JoshuaEgwuatu/Fall-2023-Autonomous-Crawlspace-Inspection-Robot/Croomba V2/Documentation/ReadMe.md

Here is a brief description of each file:

## Signoffs
- Environmental Sensing file contains 
  - Compass Subsystem.md
  - Radon Sensor subsystem.md
- Movement file contains 
  - Revamp Chassis and Motor Signoff.md

## Final BOM
Final BOM encompassing all purchases

## Full schematic 
Full design system
