JoshuaEgwuatu/Fall-2023-Autonomous-Crawlspace-Inspection-Robot/Croomba V2/Documentation/Signoffs/README.md

This repository contains two files related to environmental sensing and movement subsystems.
All files presents the subsystem's constraints, buildable schematics, analysis, and bill of materials (BOM).
The files are organized as follows:

## Environmental Sensing
- **Compass Subsystem.md**
- **Radon Sensor Subsystem.md**

## Movement
- **Revamp Chassis and Motor Signoff.md**
