JoshuaEgwuatu/Fall-2023-Autonomous-Crawlspace-Inspection-Robot/Croomba V1/Documentation/Signoffs/Movement/Signoffs/Signoff Request - Chassis and Motors.pdf

The tank chassis [1] is responsible for being the main structural frame of the robot. This kit includes the main platform, th treads that are attached to the chassis, and the motors that will drive them.

## "What it's gonna do"

Size:
The chassis needs to be of an appropriate size in order to accommodate all of the components, but also fit into the 16 inch maximum height constraint.

Speed:
The motors need to have a torque that it is strong enough to overcome the robot's weight (discussed below), but also move at an appropriate speed of 0.2 m/s. This speed of a little less than a foot per second was selected by the team to allow enough time for sensor sampling but also move at a decent pace. Additionally, the robot must be able to move up a 30 degree incline. While crawlspaces differ in the makeup and slope of the ground, a maximum scenario is considered in which the quickest change in height and length takes place, or, the steepest and most rapid 30 degree slope.

Weight:
The Autonomous Crawl Space Inspection Robot will contain navigational and environmental sensing equipment as well as power components. It is important to have an accurate measurement of all of the materials' weights so that the robot can roomba around the crawlspace. Below is a table of the components that will be used in the design.

## " Specs and Constraints"

## Signoff Request - September 16th - Chassis and Motors

Friday, September 16, 2022 9:22 PM

Signoffs Page 1

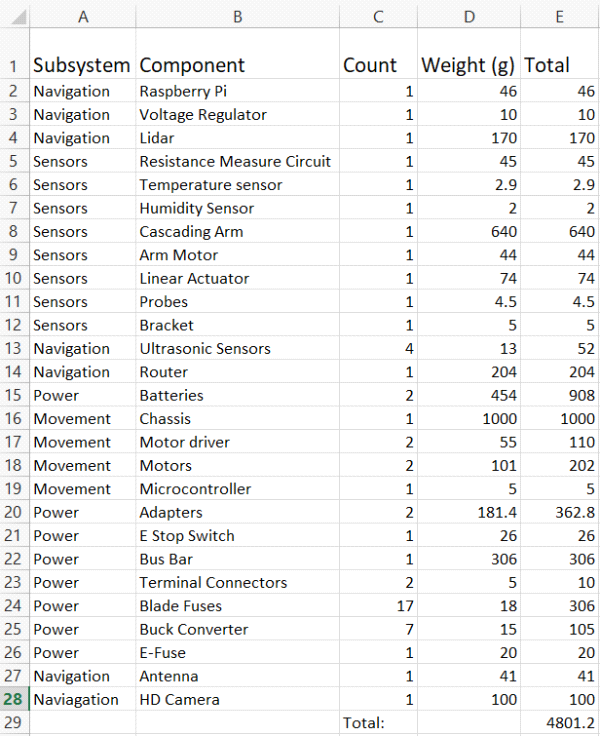
[picture p41: figure]

Table 1: Sum of Weights

Some items on the robot are not listed on the table, but are factored into the weights. An example of this instance is in the temperature sensor. Those 2.9 grams are both the arduino nano and the temperature sensor.

Additionally, this table does not indicate every piece of mass that will be added onto the robot (ex: wires). To account for (and any unforeseen circumstances), an additional calculation that assumes the robot weighs 7.2 kg, 50% more than the team expects, is made in the analysis section.

## "Analysis Compared to Constraints"

The Length Width and Height of the chassis kit in mm is 300/230/124. The surface area of the main platform is about 630 cm and the height of 124 mm is 4.88 inches, which provides the team with 11 inches worth of height for additional components such as the Lidar, Batteries, and cascading arm. More surface area can be added by attaching more platforms to the main platform included on the chassis if the need arises. Below is Figure 1, which featuresthe original kit when fully assembled. Note the amount of holes on the platforms that can be used for adding in more platforms if the need arises as well as the position

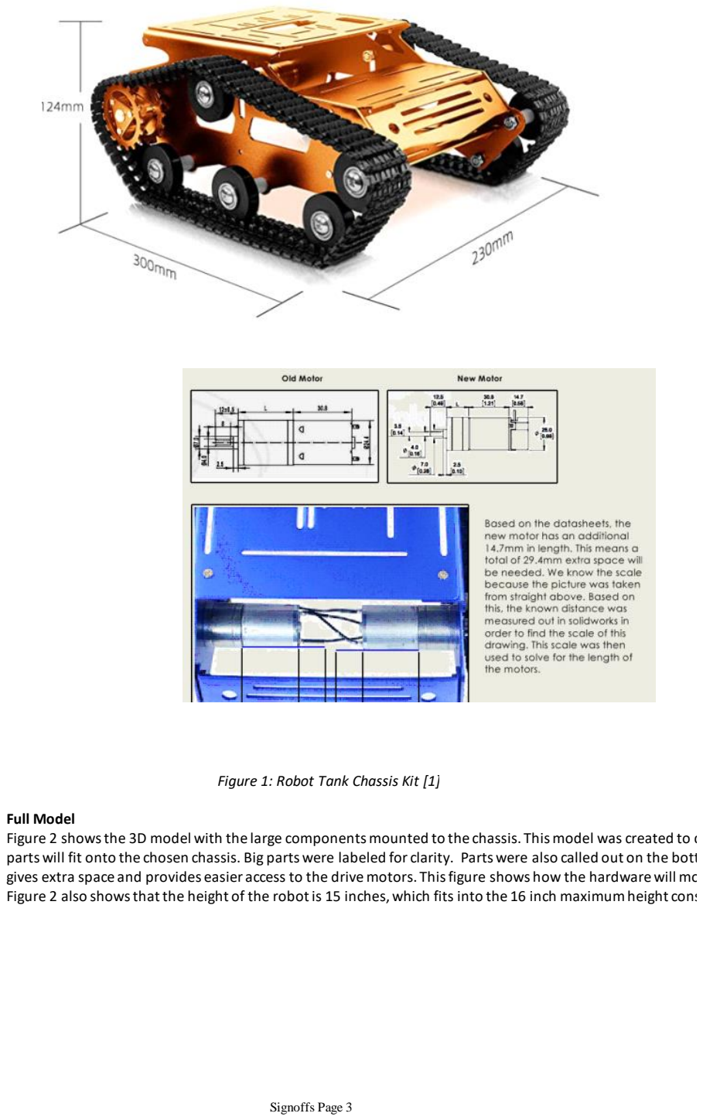
[picture p42: page 3]

Figure 1: Robot Tank Chassis Kit [1]

Full Model
Figure 2 shows the 3D model with the large components mounted to the chassis. This model was created to demonstrate that all parts will fit onto the chosen chassis. Big parts were labeled for clarity. Parts were also called out on the bottom of the
gives extra space and provides easier access to the drive motors. This figure shows how the hardware will mount onto the chas Figure 2 also shows that the height of the robot is 15 inches, which fits into the 16 inch maximum height constraint.

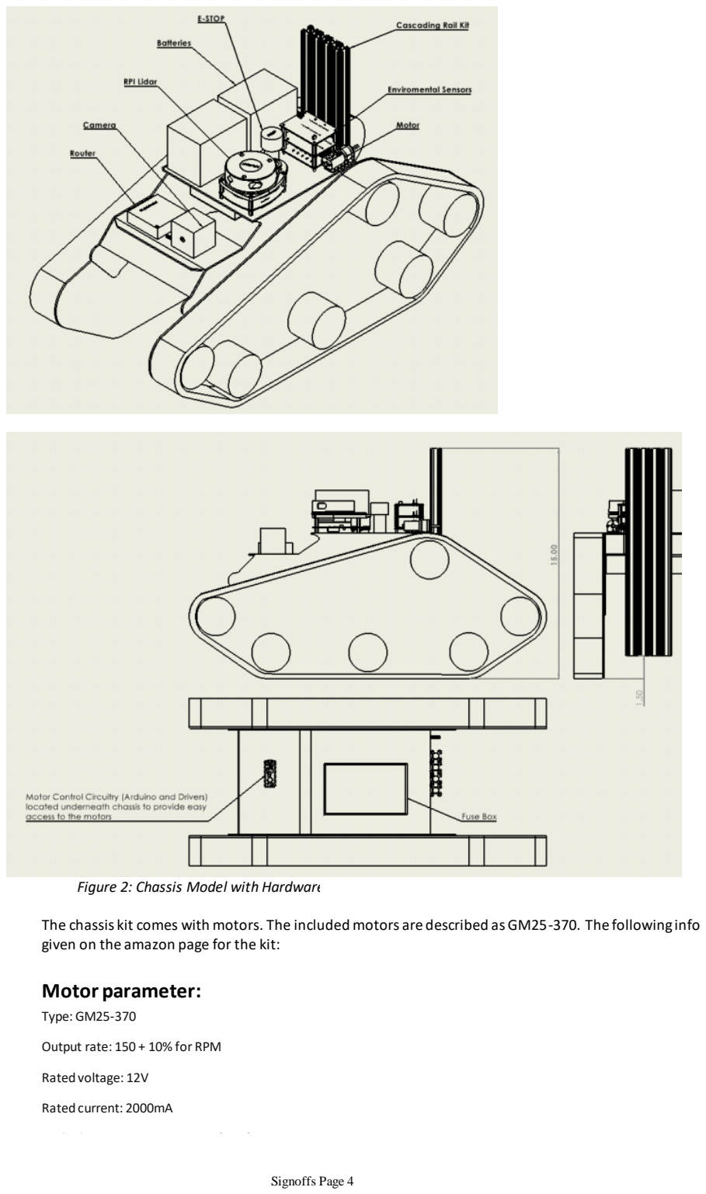
[picture p43: page 4]

Figure 2: Chassis Model with Hardware

The chassis kit comes with motors. The included motors are described as GM25-370. The following information is all that is given on the amazon page for the kit:

## Motor parameter:

Type: GM25-370

Output rate: 150 + 10% for RPM

Rated voltage: 12V

Rated current: 2000mA

Locked-rotor current: 4500 mA (Max)

KgNaN locked-rotor torque: 9.5kgNaN

Load speed: 100 + 10%rpm

[1]

The load torque: 3000 gNaN

A quick google of the part number brings up information on it from Pololu. Figure 3a shows the original motors physical dimensions. Based on the above information it is best assumed that the included motor has a reduction ratio of 34.

- The motor size must have a shaft diameter of 4mm with length of 12.5mm
- The new motor must be 25 mm in diameter
- The new motor must not exceed a length of 79.7mm in order to fit under the chassis

After comparing the specs provided in the product description on amazon with the different variations of the motor on pololu. The specs given on the motors included in the kit are inconsistent and undetailed, so to ensure a buildable and working produ new motors that can accommodate the design will be chosen. However, the new motor MUST have similar physical dimensions to the one included in the kit so that the included motors can be easily replaced. The physical size constraint for the motor follows:

To identify the strength and speed of the potential motor some calculations need to be made.

Inputs:
Wheel Radius: 0.01524 m (measured length of drive wheel in the kit)
Weight: 4.8 kg
Forward Velocity: 0.2 m/s
Max Incline: 30 degrees
Acceleration up incline: 0.1 m/s²

Angular velocity = forward velocity/ radius of wheel
=> (0.2m/s) / (0.01524m) = 13.1234 rad/s
=> (13.1234 rad/sec) * (1 rev/2pi rad) * (60 sec/min) = 125.3189 rpm

In the following torque equation, we divide by 2 to account for the 2 wheel drive.
Also, 125 rpm is about 56% of the max no load 220 rpm. We see from electronics stack exchange that torque, rpms, and efficiency all intersect at about 50% [2]. With the 56% of rpms calculated above, we'll assume a 50% efficiency in the calculations below. This accounts for some drops in efficiency possibly due to overheating or other stimuli.
Output Torque = (100/efficiency) * (weight * radius of wheel * (accel + g*sin(theta))) / 2
= (100/50) * 4.8kg * 0.01524m * (0.1 m/s² + 9.81*sin(30)) / 2 = 0.358391 Nm
Converting: 0.3583391Nm / (9.81m/s²
) * (100cm/m) = 3.732192 kgcm

3.732192 * 1.5 = 5.598288 (The aforementioned calculation that shows if the robot weighs 50% more than the team expects, then the motors can still handle it)

Current = Torque*angular velocity / voltage
3.732192 kgcm * 13.123 rad/sec / 12 V = 0.40028 A each

Based upon the calculations, a motor from pololu was chosen as the drive motors for the Autonomous Crawl Space Inspection Robot: Pololu item number 4845 [3]. This motor has nearly identical physical dimensions as the one included in the chassis ki with the only difference being the addition of the encoder (dimensions shown in Figure 3b), and its stall torque (15kgcm), no load rpm (220rpm), and corresponding range are adequate for the above calculations. A torque curve with that information is seen in Figure 4. The green dot represents the operating point for the robot, and it is well within the torque. The red dot s that even if the robot ends up weighing 50% more than the team expects (7.2 kg) then the motors will still be able to support the load. Comparing the motor lengths, diameter, and placement of the mounting holes shows that the mounting holes on the

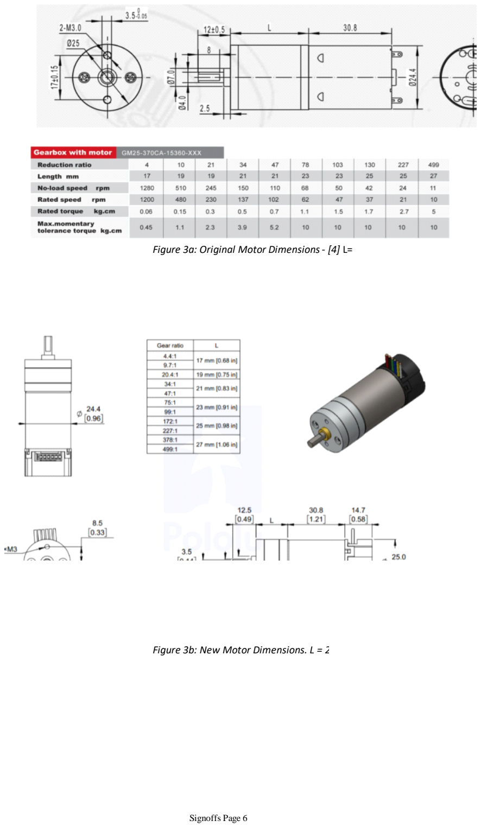
[picture p44: page 6]

Figure 3a: Original Motor Dimensions - [4] L= 21

Figure 3b: New Motor Dimensions. L = 21

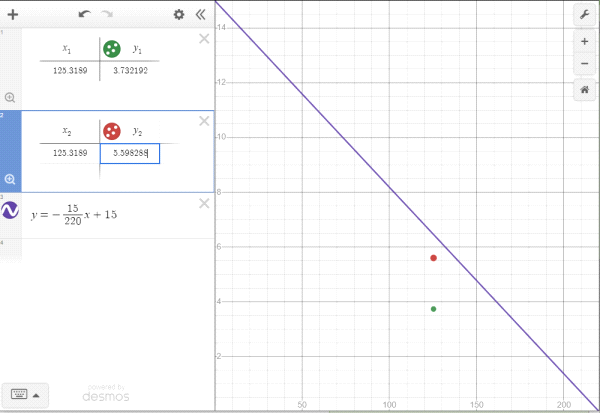
[picture p45: figure]

Figure 4: Torque Curve
X Axis: Speed (rpm)
Y Axis: Torque (kgcm)
An additional bonus of the selected motor is that it comes equipped a Hall Effect encoder that can be used to monitor the speed at which the motor is operating. However, the encoder adds an additional 14.7 mm onto the back of each motor. Referencing back to figure 1, it can be seen that the 29.4 mm of space necessary for the encoders is available. Therefore, the new motors will fit into the same space that the old motors used. Figure 5 gives a description with pictures on how the motor and encoder wires are to be connected.

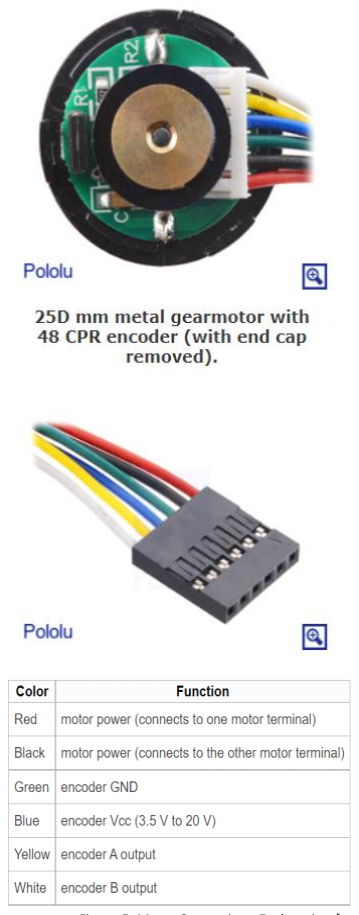
[picture p46: figure]

Figure 5: Motor Connections Explanation [3]

New Constraint: The 5A stall current of the motors places a constraint on to the motor driver that will be used to control th This information will be considered and analyzed in a future signoff.

These new motors will attach to the chassis in the same way that the original motors would have. Figure 6 shows the motor model, and Figure 7 shows how the motors will mount onto the chassis (Figure 7 is NOT a video. It is a photo taken from one, but the video can be found through source 1). The motors are attached to each side of the chassis by using two screws a piece The man seen in Figure 7 is installing a motor onto the chassis. Since the originally included motors and newly selected moto are physically identical, the new ones will mount in the same way.

Motor Mounting:

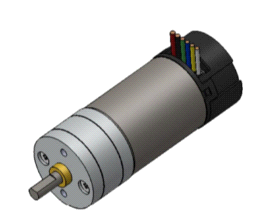
[picture p47: figure]

Figure 6: Motor Model - [3]

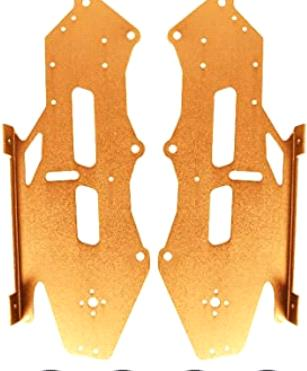
[picture p48: figure]
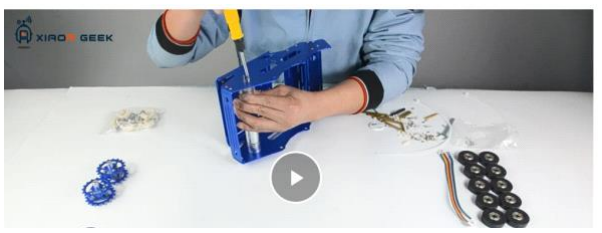
[picture p49: figure]

Figure 7: Motor Mounting - [1]

Each Pololu Motor costs $48.95 The Chassis Kit costs $74.99

[1] Chassis Kit (https://www.amazon.com/XiaoR-Geek-Aluminum-Raspberry-Absorbing/dp/B077Z4GYLB?hvadid=533431677067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)
[2] Typical Motor Efficiency (https://electronics.stackexchange.com/questions/237681/brushed-motor-torque-and-efficiency)
[3] Pololu Motor 4845 (https://www.pololu.com/product/4845)
[4] Original Motors (https://www.amazon.com/Gm25-370-Reduction-Motor-Gearbox-Robots/dp/B014R33IUY)
