JoshuaEgwuatu/Fall-2023-Autonomous-Crawlspace-Inspection-Robot/Croomba V1/Documentation/Signoffs/Power/Signoff Request - 4_18 - Battery signoff.pdf

Battery Adapter Subsystem Specifications

The battery adapter subsystem will provide a nominal voltage of 20 V and a maximum current of 10 amps for distribution via the 12 gauge wires.

Analysis
A variable resistor and digital multimeter will be used the verify that current and nominal voltages are being met. Readings of voltage will be taken across various resistance values to determine the nominal voltage of the battery/adapter system. The correct operation of the kill switch will be determined with the resistance and multimeter as well. Then using two 1 ohm resistors in series the fuse operation will be verified to ensure that system will break the circuit if currents reach unsafe levels. The figure below shows a buildable schematic of this analysis

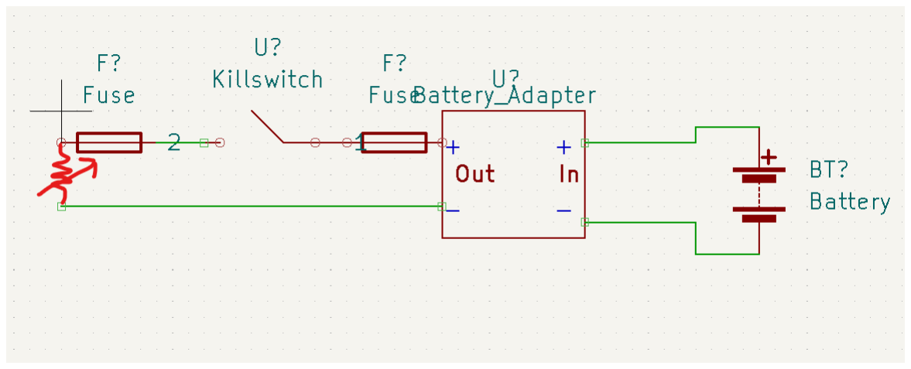
[picture p74: figure]

Battery Adapter Subsystem Expectations

The purpose of the battery adapter subsystem is to provide a safe connection from the battery terminals to the wires. There are four elements to this subsystem. The first element is the battery itself. The battery will provide current and voltage to the second element, the adapter. The adapter will be placed on the chassis attached with a shim. The adapter has a kill switch and fuses to protect the last element of the subsystem, the wires. The wires will be used to connect the rest of the power system together.

Battery - 20 V(max) 5.0 Ah https://www.amazon.com/DEWALT-DCB205-2-Lithium-Battery-2-Pack/dp/B00KQU1ENG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 (https://www.amazon.com/DEWALT-DCB205-2-Lithium-Battery-2-Pack/dp/B00KQU1ENG)

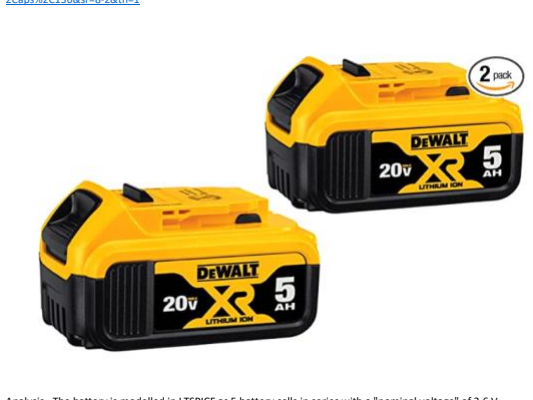
[picture p75: figure]

Analysis - The battery is modelled in LTSPICE as 5 battery cells in series with a "nominal voltage" of 3.6 V each. The tolerance was estimated to be 10% each. A monte-carlo simulation was executed with a simple resistive load to show some possible values :

# Signoff Request - 4/18

Monday, April 18, 2022 7:48 AM

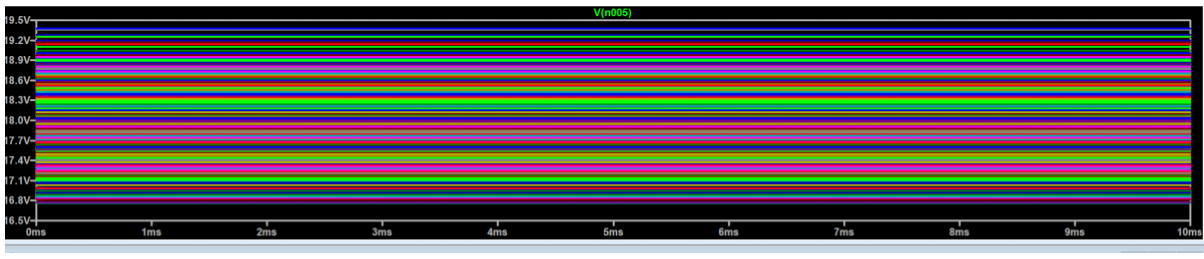
[picture p76: figure]

Journal - John Harris Page 1

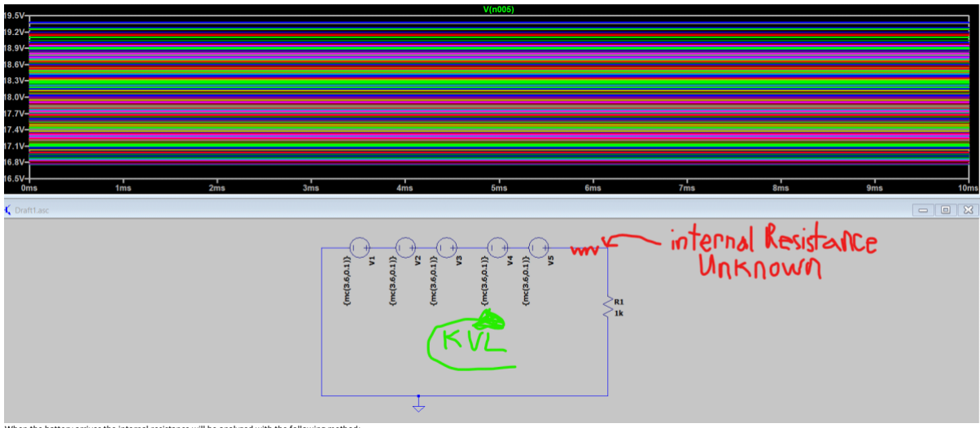
[picture p77: figure]

When the battery arrives the internal resistance will be analyzed with the following method:

The No Load Voltage will be determined at full charge by connecting a multimeter across the battery terminals. The Voltage will be recorded as the No-Load Voltage.

Once the No-Load Voltage is determined the external resistor's resistance will be measured and recorded with a multi meter. The resistor will be connected to the battery. The voltage will be measured across the resistor quickly to avoid damaging the battery.

Once the Voltage Across the external 1k resistor is known the Current will be determined by I = V/R

Once the current is known a KVL will be performed to determine the internal resistance : (no_load_voltage) = (current*internal_resistance) + measured_external_voltage

internal_resistance = no_load_voltage - measured_external_voltage / current

The internal resistance will be recorded and used to monitor battery health by repeating the experiment during trouble shooting if necessary.

Wire - (if not available in lab) https://www.amazon.com/dp/B08R34NG4P/ref=twister_B08XVR3YYD?th=1 (https://www.amazon.com/dp/B08R34NG4P/ref=twister_B08XVR3YYD?th=1)

Analysis: 12 gauge wire rated for a maximum of 9.3 A with about 1.5 ohm resistance every 1000 ft.

Inline Fuse - waterproof will use 2 in series ATC/ATO standard blade fuse 12 Gauge wire https://www.amazon.com/dp/B07RY8Y2QV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 wNjg4NzA1MTFLSFAzOEhJVEtZNSZlbmNyeXB0ZWRBZElkPUEwNDg5MzUzMU9aTTFGNVo4UVE0OSZ3aW RnZXROYW1lPXNwX2RldGFpbF90aGVtYXRpYyZhY3Rpb249Y2xpY2tSZWRpcmVjdCZkb05vdExvZ0NsaWNr PXRydWU= (https://www.amazon.com/dp/B07RY8Y2QV?s=automotive)

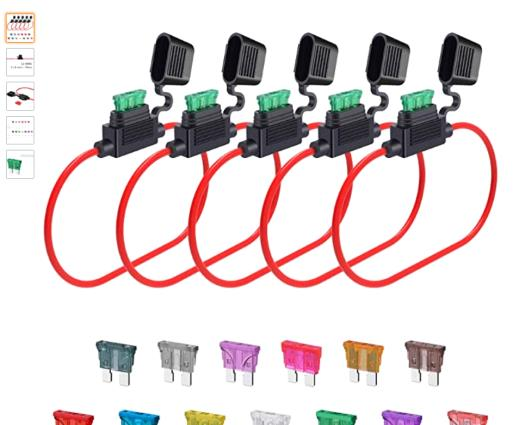
[picture p78: figure]

Analysis - The 12 gauge wire in line fuse of 10 A will break circuit if unsafe levels of current for wire are detected.

Battery Adapter - Integrated Kill Switch and Inline Fuse https://www.amazon.com/dp/B09HTB57MC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 NjI4MzgzM0gxMURROFlNQlZVMSZlbmNyeXB0ZWRBZElkPUEwNzQ2MzU5MklKNlczNUZERE1WNiZ3aWR nZXROYW1lPXNwX2RldGFpbF90aGVtYXRpYyZhY3Rpb249Y2xpY2tSZWRpcmVjdCZkb05vdExvZ0NsaWNrP XRydWU&th=1 (https://www.amazon.com/dp/B09HTB57MC?s=electronics)

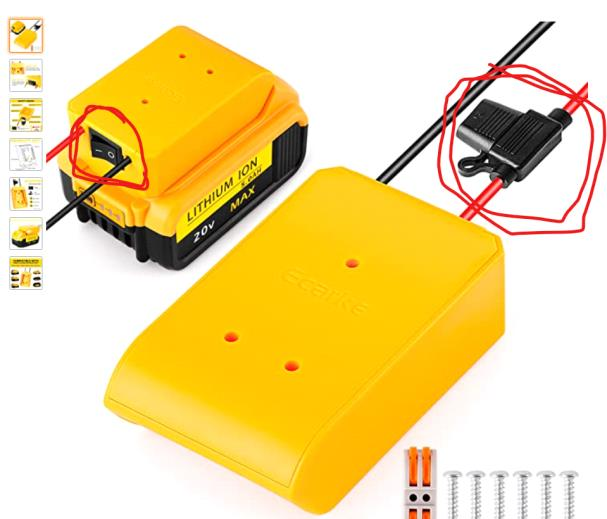
[picture p79: figure]

Analysis - 12 gauge wire with a 10 A fuse to break circuit if current gets too high

Attachment- The following figures illustrate the proposed method for adapter attachment to robot chassis. Care was taken to place batteries in a position that does not interfere with LIDAR or moisture probe.

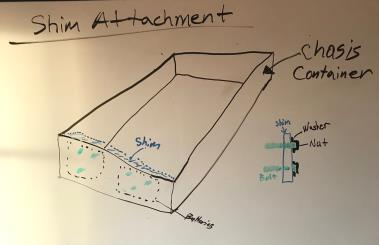
[picture p80: figure]
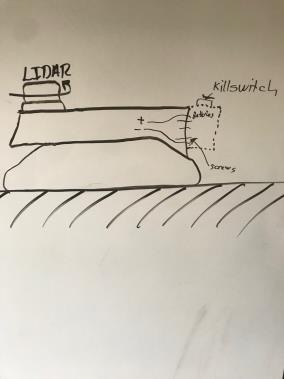
[picture p81: figure]

Battery Charger - (if not available in lab)

https://www.amazon.com/DEWALT-DCB118-FLEXVOLT-Fast-Charger/dp/B01HD4E0LK?th=1

Analysis - No analysis for this component it may not be necessary if a charger can be found
