JoshuaEgwuatu/Fall-2023-Autonomous-Crawlspace-Inspection-Robot/Croomba V1/Documentation/Signoffs/Power/SignoffRequest-914.pdf

## Signoff Request - 9/14

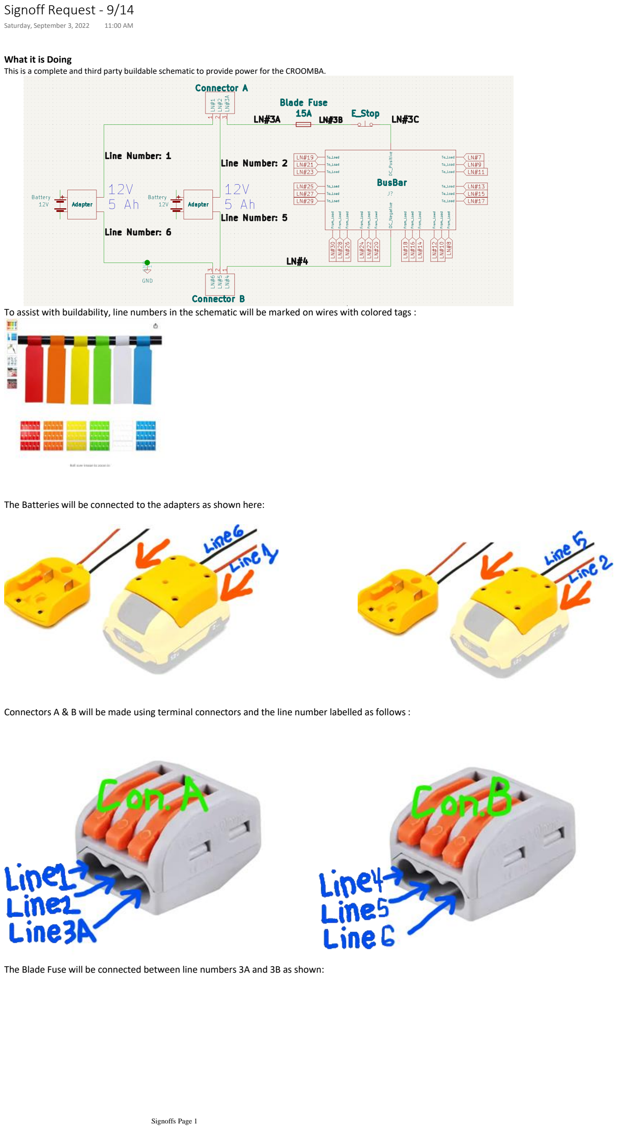
[picture p82: page 1]

What it is Doing
This is a complete and third party buildable schematic to provide power for the CROOMBA.

To assist with buildability, line numbers in the schematic will be marked on wires with colored tags :

The Batteries will be connected to the adapters as shown here:

Connectors A & B will be made using terminal connectors and the line number labelled as follows :

The Blade Fuse will be connected between line numbers 3A and 3B as shown:

Saturday, September 3, 2022 11:00 AM

Signoffs Page 1

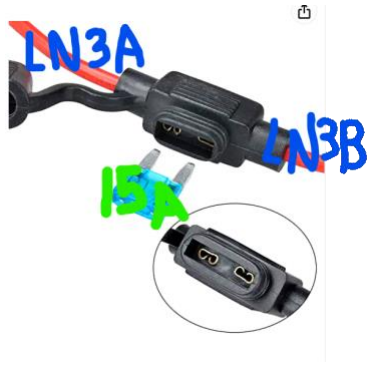
[picture p83: figure]

The on/off switch will be connected between line numbers 3B and 3C as shown here:

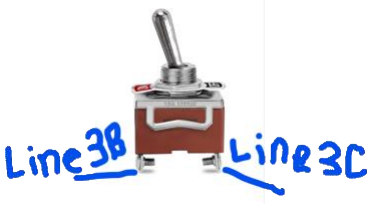
[picture p84: figure]

To complete the circuit, the busbar will be wired and labelled as follows:

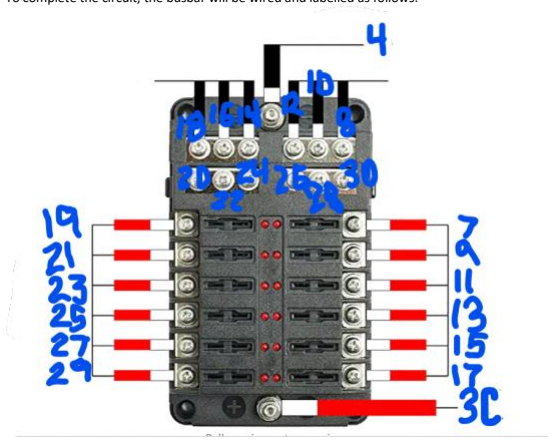
[picture p85: figure]

[1] Batteries (https://www.amazon.com/DEWALT-DCB126-2-Lithium-Batteries-2-Pack/dp/B08SKPTX4J)
[2] Adapters (https://www.amazon.com/gp/product/B09N42RJKW/ref=ask_ql_qh_dp_hza)
[3]E-Stop (https://www.amazon.com/MGI-SpeedWare-Latching-Toggle-Switch/dp/B08YYDPKR2?pid=J8qPn3Q&s=industrial)
[4]Bus Bar (https://www.amazon.com/dp/B093RF3VWC?s=automotive&sp_csd=d2lkZ2V0TmFtZT1zcF9kZXRhaWxfdGhlbWF0aWM)
[5]Wires (https://www.amazon.com/BNTECHGO-Silicone-Flexible-Strands-Stranded/dp/B01AAX65ZK)
[6]Terminal Connectors (https://www.amazon.com/dp/B09CKH8B5Q?s=industrial&sp_csd=d2lkZ2V0TmFtZT1zcF9kZXRhaWw)
[7]Blade Fuses (https://www.amazon.com/MUYI-Holder-Waterproof-Pigtail-Inline/dp/B07DHMHN4W)
[8]Micro USB Breakout (https://www.amazon.com/Poyiccot-Terminal-Connector-terminals-Pluggable/dp/B07PPXMTLL)
[9]USB C Breakout (https://www.amazon.com/dp/B08D93ZSM4?s=industrial&sp_csd=d2lkZ2V0TmFtZT1zcF9kZXRhaWw)

Constraints (FOR BUCK CONVERTER COMPONENT CONSTRAINTS SEE OTHER SIGNOFF REQUEST PLEASE)

Batteries- 12V Nominal output max of 5 amps in one hour before voltage begins to drop.
Wires- 14 gauge carry a maximum current of 15 Amps
Terminal Connectors- Rated for the gauge wire they are sized for.
Bus Bar- 100 Amp maximum current
E-Stop- 20 Amps at 12 Volts
Blade Fuses- 14 gauge 20 amp is listed as maximum current
Arduino Every- The USB port needs to kept open for serial communication between the Pi. It has an on board DC/DC converter input is 7-21V.

1. The power system must be portable. No plugs because they would get tangled.
2. Prevent fire hazard with overcurrent protections.
3. Distribute voltage and current to all components.
4. The Arduino and Raspberry Pi require a low ripple input voltage. This constraint is referred to as a ripple rejection and will require simulation in the Analysis to fully quantify.
4a. Arduino - The power for this system will enter through an onboard component called a Low Drop Out (LDO) Linear Voltage Regulator. The specific model used is LM1117IMPX-5.0. (https://www.digikey.com/en/products/detail/texas-instruments/lm1117impx-5-0/3697262) The Constraint for this comes from the maximum peak to peak voltage ripple this component can successfully filter out. The power then enters the ATMEGA328P and FT232RL. The voltage tolerance for these two components determine the allowable ripple.

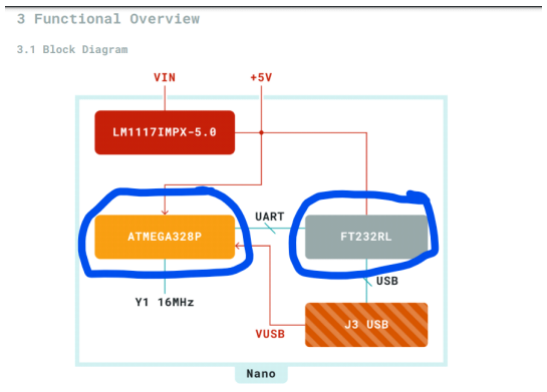
[picture p86: figure]
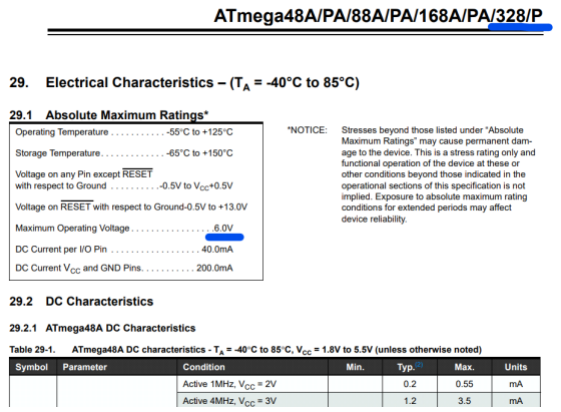
[picture p87: figure]
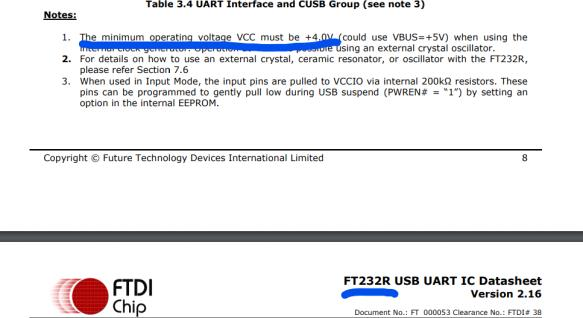
[picture p88: figure]

The maximum Ripple Allowed On the output of the LDO when both of these Components are considered is 1 V pk-pk

The LDO Regulator has a ripple rejection of 75dB:

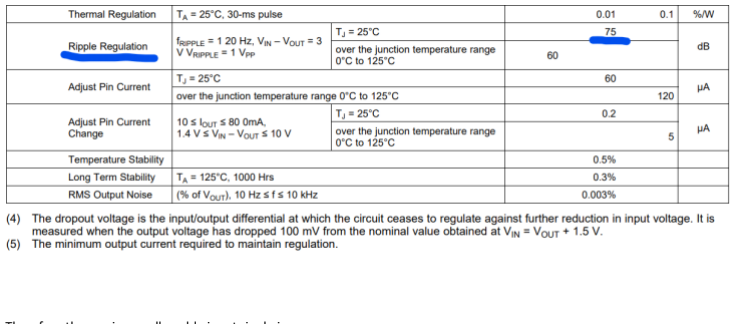
[picture p89: figure]

Therefore the maximum allowable input ripple is:

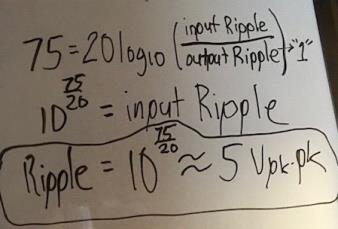
[picture p90: figure]

5V pk-pk

The Logic line for the H bridge drivers is powered through an on board L78M05 (https://www.digikey.com/en/products/detail/stmicroelectronics/L78M05CP/1165897) LDO which has a ripple rejection of 62 dB. The datasheet for the MOSFET (https://www.st.com/resource/en/datasheet/l298.pdf) of the driver indicates an absolute maximum in the logic line of 7V which indicates an output on the LDO of at most 2V pk-pk. With the ripple rejection the LDO is capable of this indicates a maximum input ripple of 2.5 V pk-pk

4b. Raspberry Pi - Here the power supply of the Raspberry Pi is used to determine the acceptable peak to peak voltage ripple.

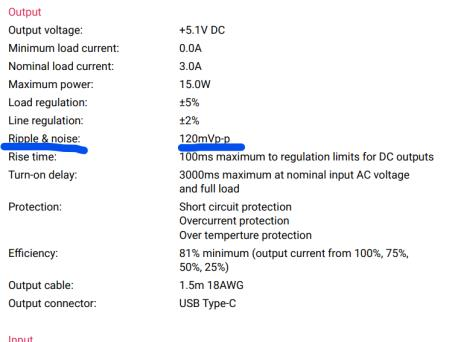
[picture p91: figure]

0.12V pk-pk

Analysis

Noise Simulation
In order to analyze the noise in the system we must simulate a ripple in a buck converter and come up with an implementable s olution for it. The Phenomenon of a ripple in the buck converter's voltage output is caused from a time varying magnetic flux density (when the inductor of the motor's field collapses from starting and stopp ing) coupling into some part of an adjacent system. The circuit component that is doing the coupling is an inductance. Whether it is a discrete inductor component or an inductance that is present in all real world wires is irrelevant. This is described in Maxwell's third equation:
The ripple will therefore be modelled by coupling an inductor that is being switched on and off into a buck converter simulation:

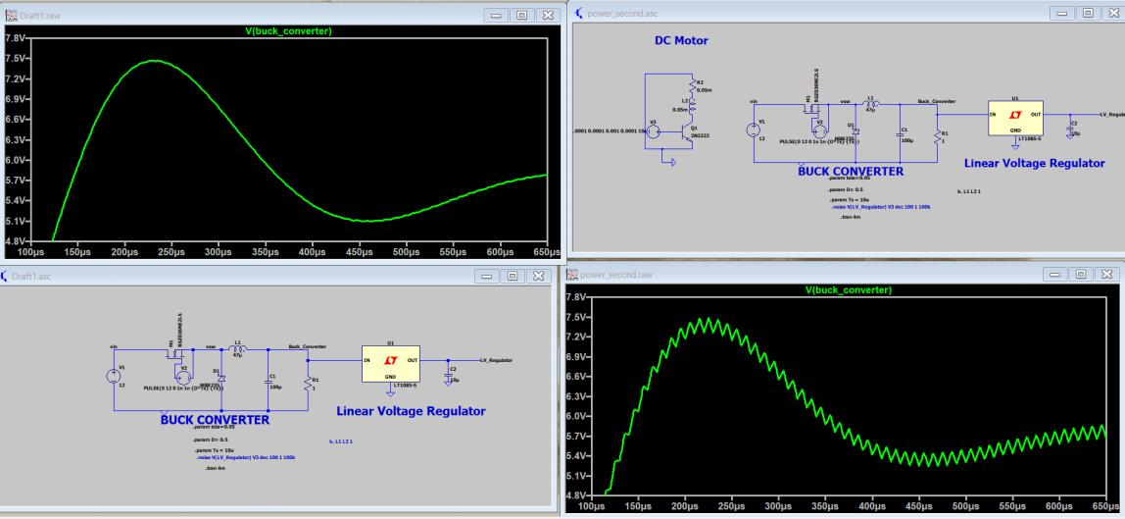
[picture p92: figure]

It can be seen from this figure that the ripple is seen on the output of the simulated buck converter. This figure shows the overall response in Comparison:

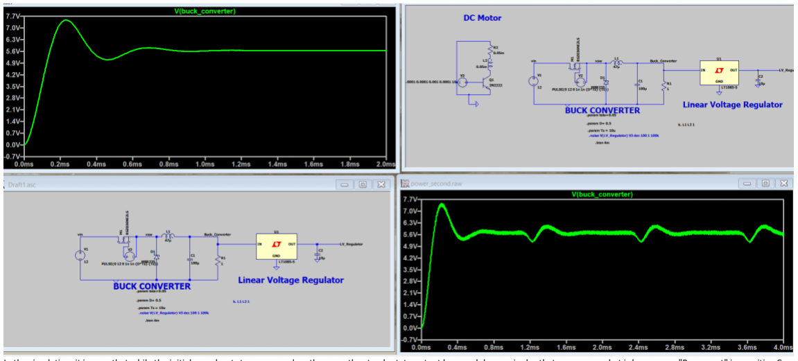
[picture p93: figure]

In the simulation, it is seen that while the initial overshoot stays more or less the same the steady state output has much l arger ripples that may cause what is known as a "Brown out" in sensitive Croomba systems if it is not controlled.

It will be demonstrated that a capacitor in parallel alleviates this problem and the response is then compared to maximum peak to peak voltage limits:

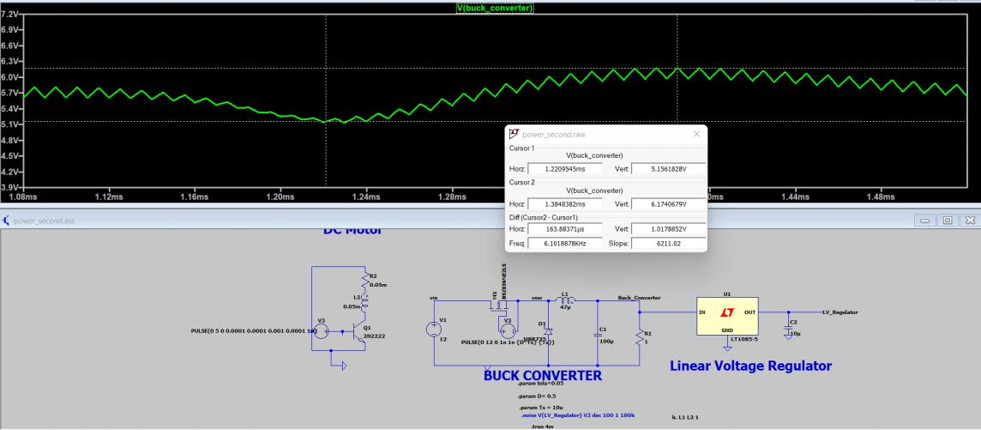
[picture p94: figure]

Here it can be seen that the voltage ripple is about 1.00V peak to peak. This puts the Design out of Specifications for the f ollowing components: Arduino: 5V pk-pk
Raspberry Pi: 0.12V pk-pk
LM298N: 1V pk-pk

A capacitor is used to decrease coupling by using the frequency of the buck converter(100kHz) and the inductance of the induc tor(47µH) with the following formula:

The required decoupling capacitor is calculated by rearranging the equation as

which is rounded to the nearest capacitance value of 0.1 .

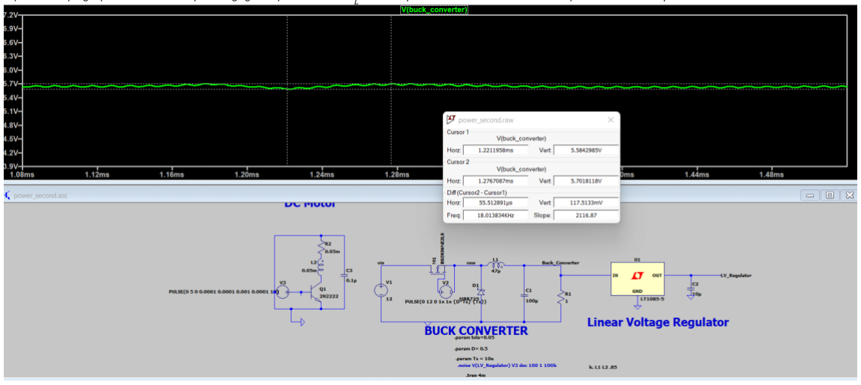
[picture p95: figure]

Here it can be seen that the voltage ripple is 0.117V peak to peak. This affects the Specifications for the following components: Arduino: 5V pk-pk
Raspberry Pi: 0.12V pk-pk
LM298N: 1V pk-pk

Here various Worst Case currents and voltages will be analyzed. In order to analyze the voltages and currents for the circuit, the loads across the bus bar must be estimated based and a noise analysis performed where possible. The analysis will proceed with a line by line estimation of the loads. Then conclude with the total load across the bus bar line numbers 3D & 4

Line 7A & 8A:

Buck Converter A >> eFuse >>Raspberry Pi

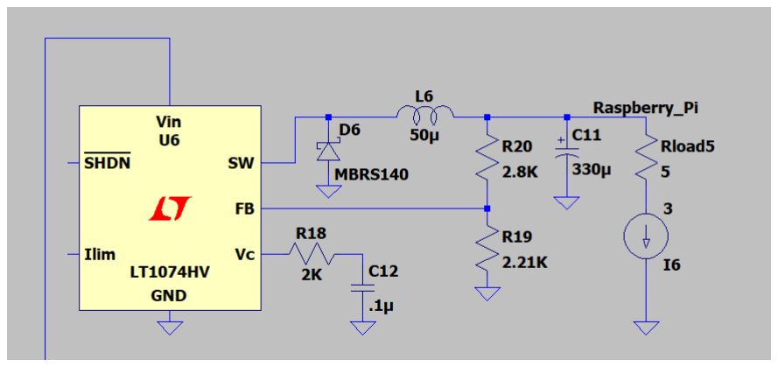
[picture p96: figure]
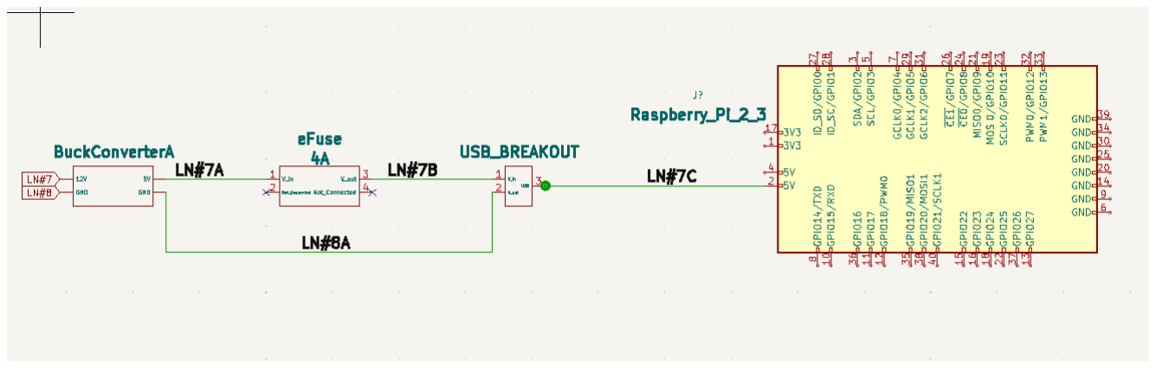
[picture p97: figure]

Worst Case Analysis
The base operating system has been installed on the Pi. It has been measured to consume 0.5 A at 5V during normal operation and 1A at 5V during start up. There will be four ultrasonic sensors that each consume 0.02A at 5V for a total of 0.08A at 5V provided through the Pi. There will be a LIDAR unit that requires 0.1A of current at 5V provided through the Pi. An HD camera will be used that consumes 0.15A at 5V provided through the Pi. A light that consumes 0.6A at 5V will be provided through the Pi. There will be an ESP32 connected that uses a maximum of 0.08A at 3.3V provided by the Pi. The input to the buck converter to provide this will have to be 5.1 * 2.01 / 12 = .854A at 12V. The buck converter efficiency at this current is about 84%, so to account for this: 0.854 * (1- 0.84 + 1) = 0.9906 A at 12V

The Worst Case current and voltage of this line is 0.996 at 12V

Line 9A & 10

This line will have the current and Voltage Requirements of the three environmental sensors for the CROOMBA. The change was made from previous signoffs to improve efficiency and reduce noise. The noise reduction happens from decreasing the total number of buck converters, which are a source of electrical noise. The buckconverters operate at an efficiency of about 75% at a load of about 0.5 Amps, but operate at an efficiency of about 83% at a load of 1.5 Amps.

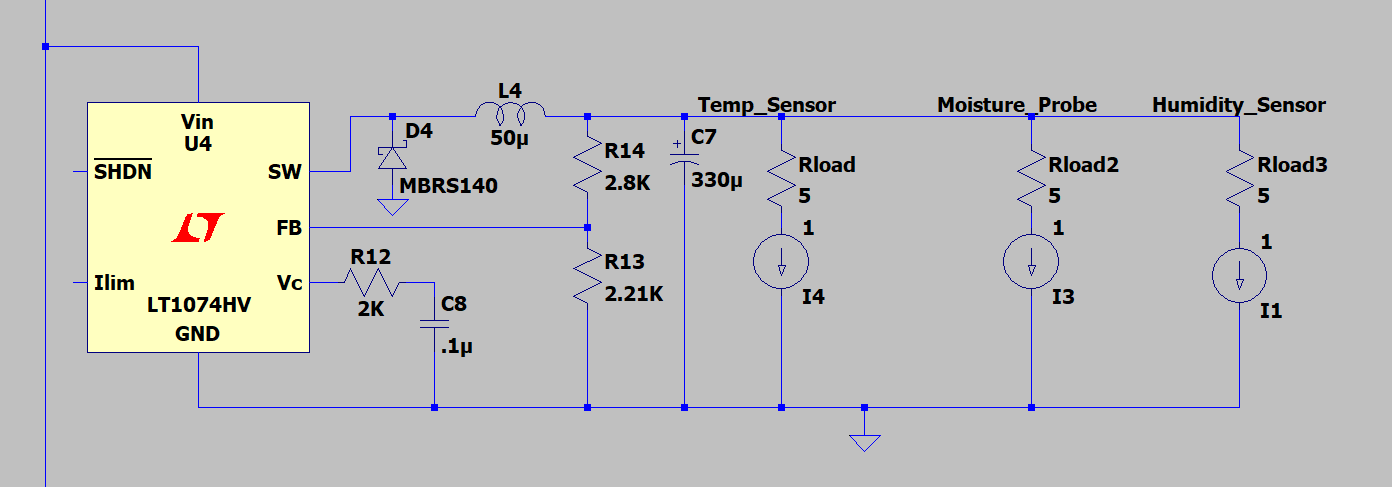
[picture p98: figure]
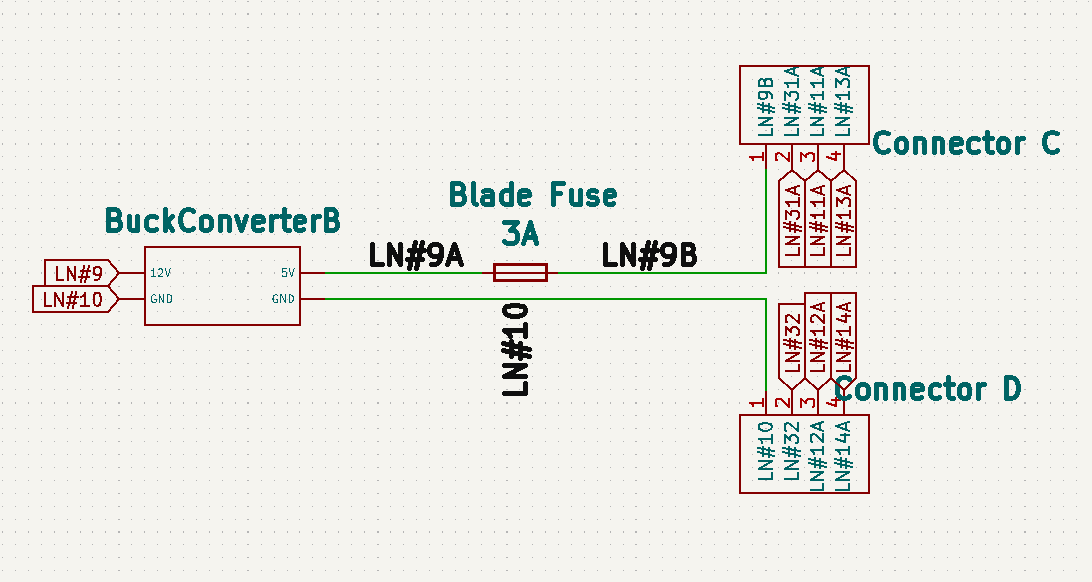
[picture p99: figure]

The input to the buck converter to provide this will have to be 5.1 * (0.785+0.785+0.3) / 12 = 0.7948A at 12V. The buck converter efficiency at this current is about 83%, so to account for this: 0.7948*(1-0.83 + 1) = 0.9299A at 12V

The Worst Case current and voltage of this line is 0.929A at 12V (Please see Lines 31A & 32, 11A & 12A, 13A & 14A for Calulations as a reminder this line is the sum of those three lines)

Line 31A & 32:
Buck Converter >> blade fuse >>Arduino Nano

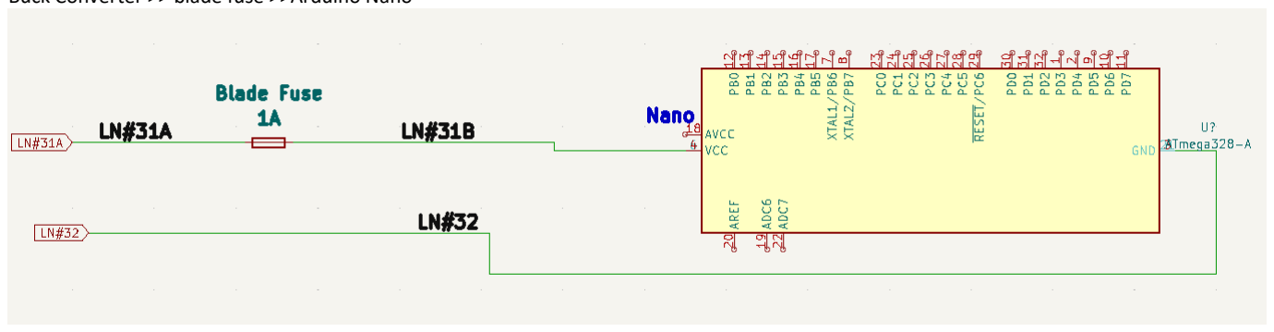
[picture p100: figure]
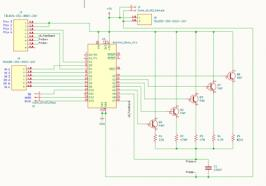
[picture p101: figure]

Worst Case Analysis
The Moisture content probe being operated by this Nano will require a maximum of 0.785 A at 5V. The calculations for this can be found in the environmental sensing signoff requests. "As shown in the schematic, this circuit is using 18 I/O pins, 14 of which will be set for output. Furthermore, only one of the auto-ranging ohmmeter pins will be outputting at a time. Along with the MCU, the auto-ranger is able to pull 0.206962 Amps through whichever transistor is active (based on LTSpice simulation created for that signoff). Adding the max board current, max pin current for each I/O pin, and the separate auto-ranger current, the maximum current pulled by this module at any point is 0.785 Amps. This measurement is a maximum however, all I/O pins will not be on at the same time or pulling max current under normal operation."

The Worst Case current and voltage of this line is 0.785A at 5V

Line 11A & 12A:
Buck Converter >> blade fuse >>Arduino Nano

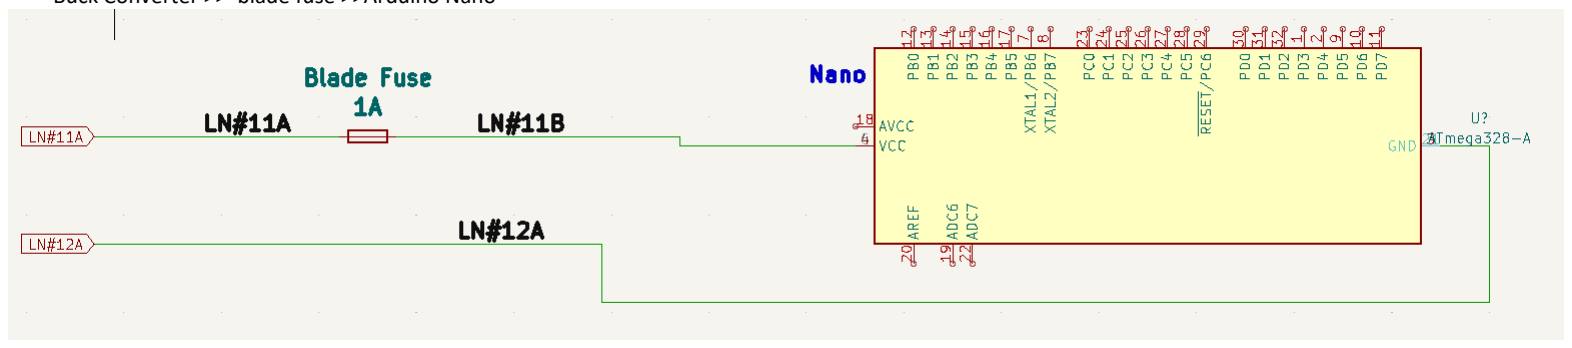
[picture p102: figure]
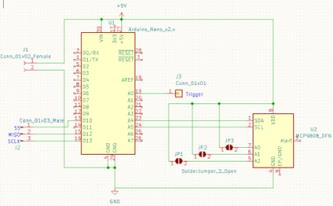
[picture p103: figure]

Worst Case Analysis
The Temperature probe being operated by this Nano will require a maximum of 0.785 A at 5V. The calculations for this can be found in the environmental sensing signoff requests. "This subsystem has 6 I/O pins being used as outputs from the Nano. The temperature sensor chip that is on its own power will pull 200 μA for its operating current based on its datasheet. (https://ww1.microchip.com/downloads/aemDocuments/documents/OTH/ProductDocuments/DataSheets/MCP9808-0.5C-Maximum-Accuracy-Digital-Temperature-Sensor-Data-Sheet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) Adding these values along with the inherent 19 mA board current shows 259.2 mA as the max current."

The Worst Case current and voltage of this line is 0.785A at 5V

Line 13A & 14A:
Buck Converter >> blade fuse >>Arduino Nano

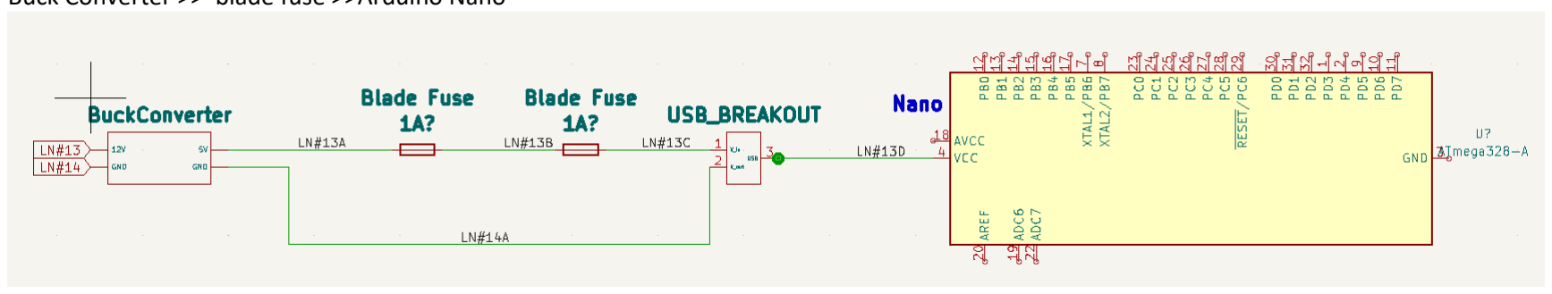
[picture p104: figure]

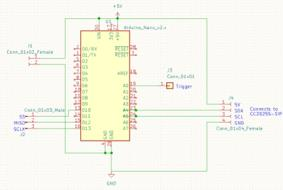
[picture p105: figure]

Worst Case Analysis

The Humidity Sensor being operated by this Nano will require a maximum of 0.3 A at 5V. The calculations for this can be found in the environmental sensing signoff requests. "This system also has 6 I/O pins in use and a separate sensor chip which, based on the datasheet, will pull a supply current of 750 mA." Adding all current values gives a total of 259.75 mA.

The current and voltage of this line is 0.3A at 5V

Line 15 & 16:
Buck Converter >> blade fuse >>Router

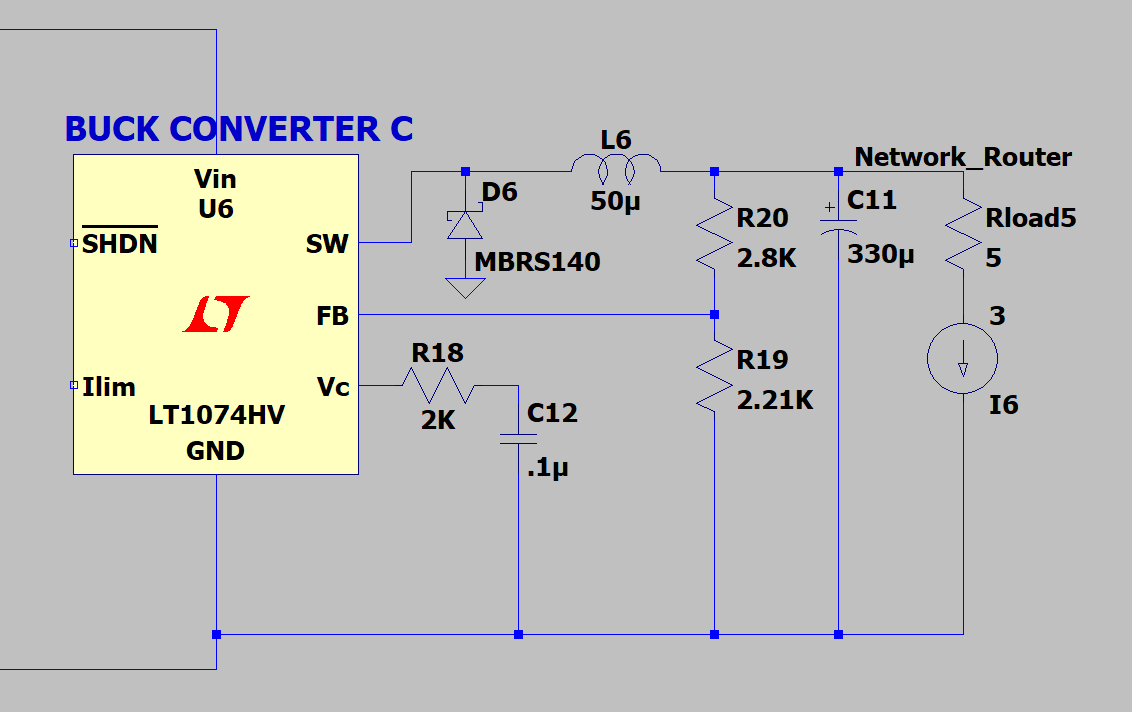
[picture p106: figure]

Worst Case Analysis
The power calculations found in the Navigation Signoff request indicate the router will use 1A at 5V."The nano router requires a constant voltage of 5 Volts and a constant current of 1 Amp for operation [3]. Over one hour, the N300 router would use approximately 1 Amp Hours (AH) and 5 Watt Hours (WH)." The input to the buck converter to provide this will have to be 5.1 * 1 / 12 = 0.425A at 12V. The buck converter efficiency at this current is about 83%, so to account for this: 0.425* (1- 0.83 + 1)=0.4973A at 12V

The current and voltage of this line is 0.4973A at 12V

Line 19 & 20:
Blade Fuse>>Blade Fuse>>L298N

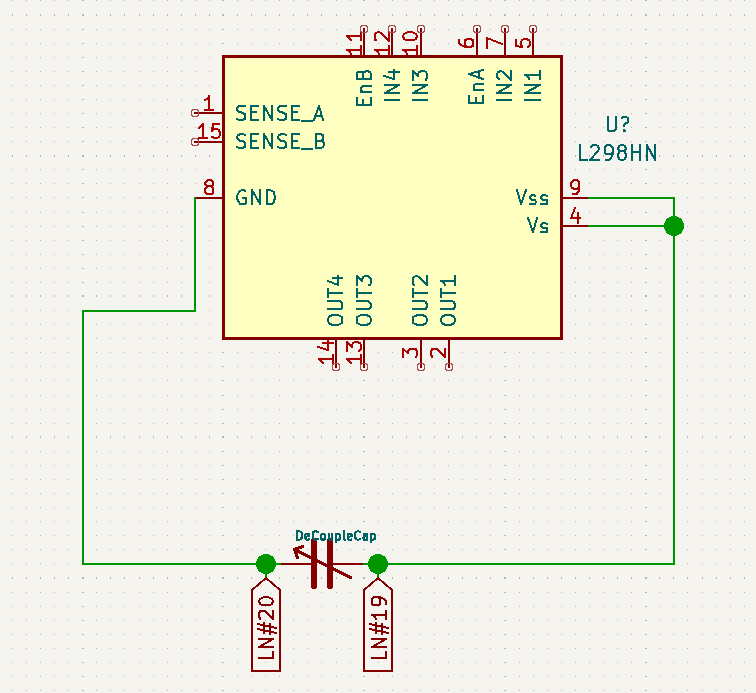
[picture p107: figure]

Worst Case Analysis
This line will provide the power used by the two DC motors that will move the CROOMBA and the logic line for the L298N. According to the datasheet for the H-bridge driver the logic supply voltage is typically 5V and the current is at a maximum (worst case) of 0.036A . The locked rotor current for the motors selected have been told to me to be : 1.8 amps * 2 motors = 3.6 A

The worst case current and voltage of this line is 3.64A at 12V

Line 23 & 24:
Blade Fuse>>Blade Fuse>>L298N

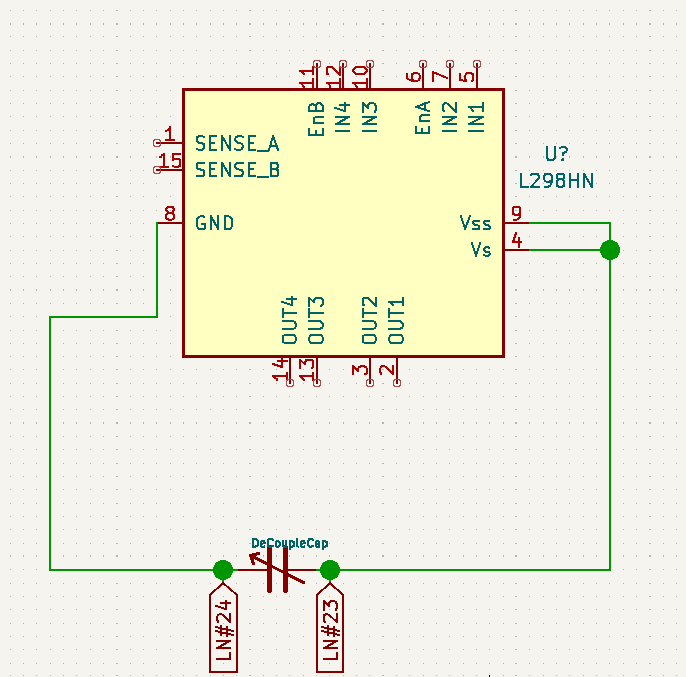
[picture p108: figure]

Worst Case Analysis
This Line will provide power to a rotational motor, a much smaller linear actuator, and the logic level of the MOSFET. According to the datasheet for the H-bridge driver the logic supply voltage is typically 5V and the current is at a maximum (worst case) of 0.036A . The motors will be powered off a separate source than the Arduinos will because they need higher voltage and will steal more current. The linear actuator has a stall current of 650 mA based on the product page while the rotational motors stall current is 1.6 Amps based on its website. The motor driver running these two can pull up to 36 mA internally when it is operating the motors based on the datasheet. This means that the total current the motors in this system will pull comes out to 2.246 Amps.

The worst case current and voltage of this line is 2.27A at 12V

Line 25B & 26:
blade fuse >> blade fuse >>Buck Converter >>Arduino Every

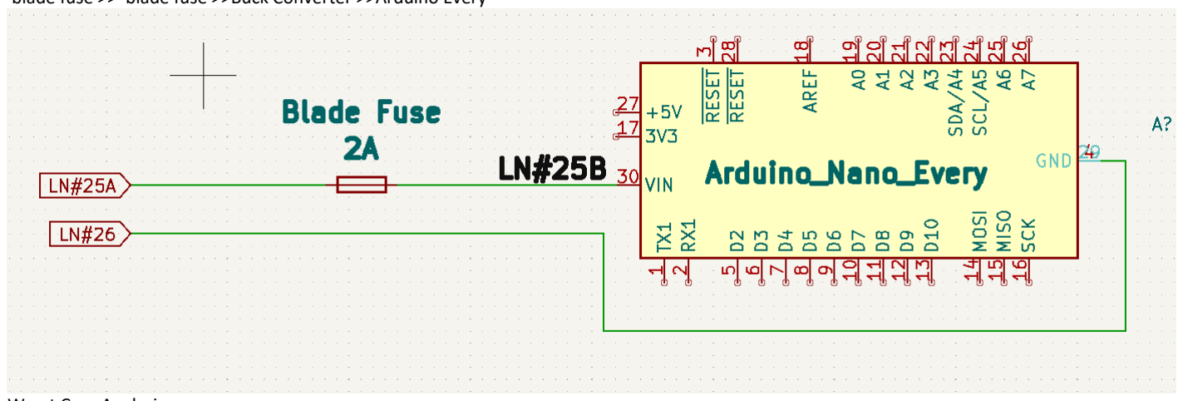
[picture p109: figure]

Worst Case Analysis
This line will provide the power for the Arduino Every. The arduino every has an on board MPM3610 DC to DC converter that, according to the manufacturer operates at 86% efficiency at 12V input. The maximum current the DC/DC converter can handle according to the datasheet is 1.2A at 12V. At 86% efficiency the board will require 1.2*(1-0.86+1) = 1.368 A at 12 .

The current and voltage of this line is 1.368A at 12V

Line 27 & 28:
Not Connected

Line 29 & 30:
Not Connected

Line 3D & 4:
The total power required will be 1.368+2.27+3.64+0.929+0.996=9.203A at 12V
The two 5 Ah batteries in parallel should be able to provide 9.203 A for 10/9.203 = 1.0866 Hours
