JoshuaEgwuatu/Fall-2023-Autonomous-Crawlspace-Inspection-Robot/Croomba V1/Documentation/Signoffs/Movement/Signoffs/Signoff Request - Motor Driver and Microcontroller.pdf

## "What it's gonna do"

The Mechanical Movement System requires Motor Drivers that will be used to control the motors and act as an interface between them and the control circuitry. This is necessary because motors operate at a high current and voltage, and the control circuit works on low current signals. [1] Speaking of control circuitry, this signoff will also be for the microcontroller that will be responsible for creating a closed feedback loop. This microcontroller will interpret movement instructions delivered by the Raspberry Pi from the Nav System, and also monitor the speed of the robot by making use of the Hall Effect Encoders that come on the selected

## "Specs and Constraints"

Microcontroller
- Communicate with the Raspberry Pi
- PWM Capability to control motor speed
- Enough GPIO pins (to be calculated below)

Motor Driver
- Accept PWM input to control motor speed
- Bidirectional movement

Specifications:

Microcontroller
- Vin must accept 12V. This constraint comes from the bus in the Power System.
- At least 2 PWM pins and channels must exist to send signals to the driver
- SPI, I2C, or Serial Capabilities must exist to communicate with the Pi.
- Read digital input of a maximum of 48 counts per revolution from the motor controller

Motor Driver
The 5A stall current from the motors means that the driver must be able to support a maximum of 5A

•

- Operate at 12V. This constraint also comes from the motors.

Constraints

## "Analysis"

The first component to discuss is the selected motor driver from Cytron Technologies, the MD20A [2].
"The MD20A enables bidirectional control of one high-power brushed DC motor from 6V to 30V. With discrete NMOS H-Bridge design, this motor driver is able to support 20Amp continuously without any heatsink" [2].
"This motor driver can be controlled with PWM and DIR inputs. With input logic voltage range from 1.8V to 12V, it’s compatible with wide variety of host controller (e.g. Arduino, Raspberry

## Signoff Request - September 16th - Motor Driver and Microcontroller

Friday, September 16, 2022 9:23 PM

Signoffs Page 1

Pi, PLC)" [2].

Since the MD20A can only support one motor, two motor drivers will be necessary; however, this helps to increase the modularity of the design by having a separate driver for each motor. The driver can be seen in Figure 1.

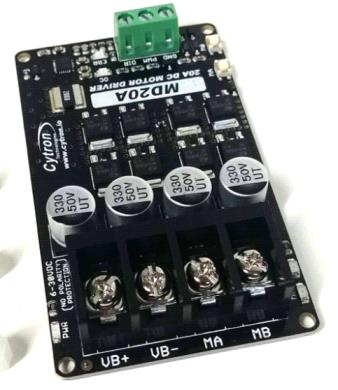
[picture p122: figure]

Figure 1: MD20A Motor Driver [2]

- The driver accepts up to 20A and 30V, which fulfils the input constraints of 12V and 5A. The driver accepts PWM input and a DIR input. This satisfies the speed control and bidirectional movement specifications.

•

The MD20A satisfies all the above specifications and constraints in the following fashion:

Figure 2 shows the connection interface as well as an input truth table. This helps show how everything will be built up, and it gives a good idea of how many pins the microcontroller will need.

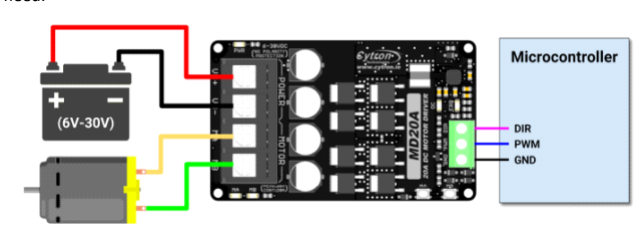
[picture p123: figure]

Figure 2: Motor Driver Connections and Input Truth Table [3]

General Analysis of Arduino Nano Every:

Now for the brains of the operation. The selected microcontroller is the Arduino Nano Every [4]. Figure 3 displays the Microcontroller, and Figure 4 shows some of the Tech Specs. With this given information, the part can be analyzed to see if it meets some of easily identifiable specs and constraints that were laid out previously. Figure 4 clearly shows that the Nano has 5 PWM pins, which satisfies the requirement of the 2 that are necessary for controlling the speed of the motors. It is also stated that the board accepts a VIN of anywhere from 6-21 V. This is acceptable because the board can be connected to the 12V line. The Arduino can also communicate with the Pi by means of USB, SPI, I2C, or UARP. This allows for a variety of methods for communication, and this will be discussed more later on. Finally, the GPIO pins

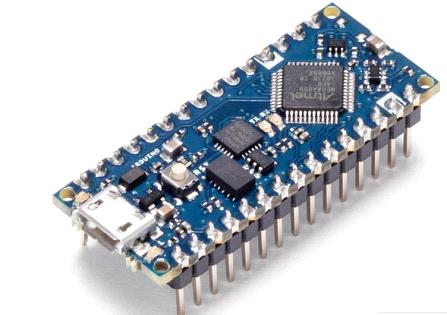
[picture p124: figure]
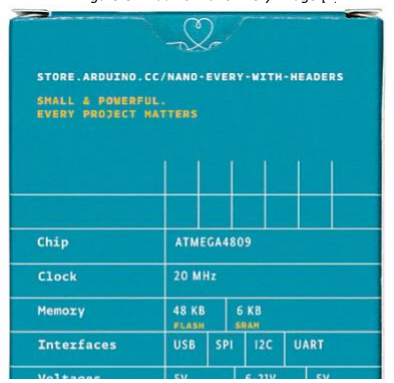
[picture p125: figure]

Figure 3: Arduino Nano Every Image [4]

Figure 4: Arduino Nano Specs [4]

GPIO Pins:
2 of the digital pins will be used for the PWM signals to the motor drivers respectively. Another 2 pins will be used as the DIR signals to the drivers respectively. This takes care of all the pins used on the motor drivers. Figure 2 shows those GND wires going from the driver to the microcontroller, but connecting to the robots main ground line will do. Additional pins will be need to be connected to the Hall Effect Encoders on the motors. This will allow the microcontroller to monitor the speed at which the robot is moving. Figure 5 shows the motor connections. The Yellow and White wires from each motor need to be connected to the microcontroller. This results in another 4 pins being used. It is also important to consider how the Arduino will communicate with the Raspberry Pi. Using UART, an additional 2 pins with TX and RX capability will be required. The Arduino Nano Every has 14 digital pins and 8 analog pins ready to go. That number is enough to satisfy the 10 pin requirement with 2 of those pins being PWM and another 2 for TX and RX. Figure 6 shows the pinout of the Arduino Nano Every board. In Figure 6, the PWM compatible digital pins are denoted with a "~" in the pinout. Those pins

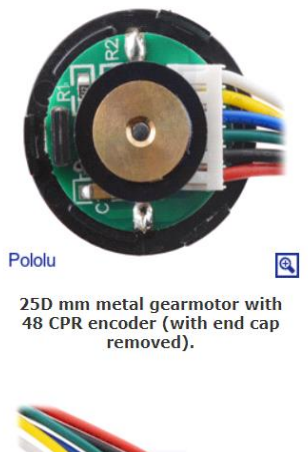
[picture p126: figure]

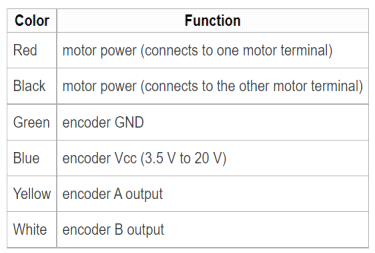
[picture p127: figure]

Figure 5: Motor Connections Explanation [5]

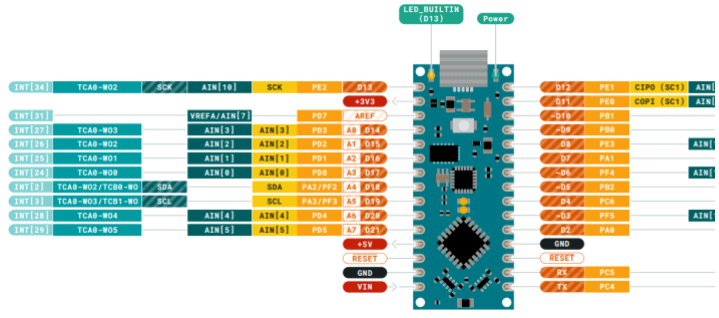
[picture p128: figure]
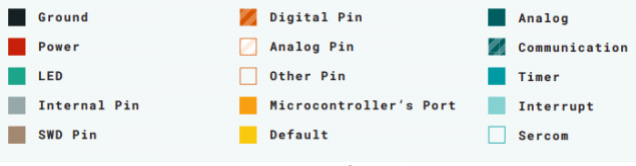
[picture p129: figure]

Figure 6: Arduino Nano Every Pinout [4]

Communication Protocol:
Next up is the analysis for how the Arduino will communicate with the Raspberry Pi. The selected protocol of UART allows for full duplex communication so that the Arduino and Raspberry Pi can communicate with one another at the same time. UART has many benefits such as only using two wires (TX and RX) and it does not require a clock. The TX pin (digital pin
1) will connect to the Pi's GPIO pin 10 which is RX 1. The Arduino's RX pin (digital pin 0) will be connected to the Pi's GPIO pin 8 which is TX1. This allows the two devices to talk to one another simultaneously. Figure 7 depicts the connections, and Figure 8 shows the other items connected to the pi. This proves that there are enough pins and other connection points to go around. BIG NOTE!!! Figure 8 shows the INCORRECT CONNECTIONS for the Arduino Nano Every!

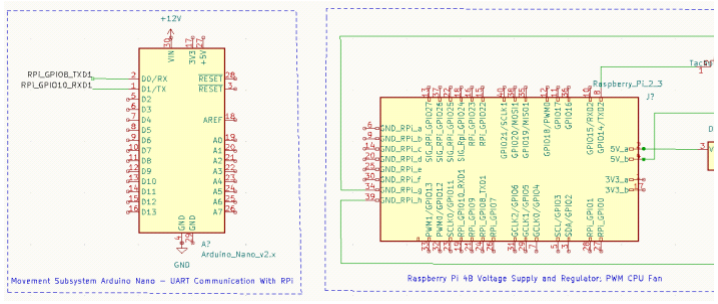
[picture p130: figure]

Figure 7: Serial Communication Connections

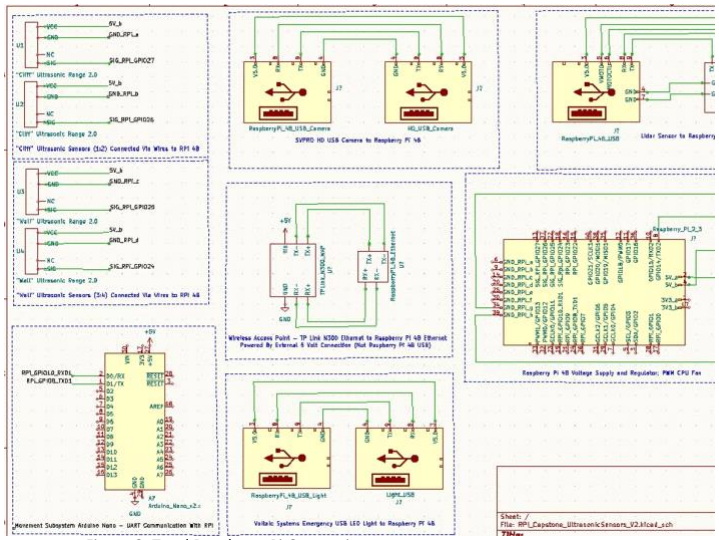
[picture p131: figure]

Figure 8: Total Raspberry Pi Connections

Hall Effect Encoder Signal Reception:
The selected motors come with integrated Hall Effect Encoders; the connections to which are shown in Figure 9. "A two-channel Hall effect encoder is used to sense the rotation of a magnetic disk on a rear protrusion of the motor shaft. The quadrature encoder provides a resolution of 48 counts per revolution of the motor shaft when counting both edges of both channels. The Hall sensor requires an input voltage, Vcc, between 3.5 and 20 V and draws a maximum of 10 mA. The A and B outputs are square waves from 0 V to Vcc approximately 90° out of phase. The frequency of the transitions tells you the speed of the motor, and the order of the transitions tells you the direction" [5]. Those output square waves are digital signals that will be inputted to and interpreted by the Arduino Nano Every in order to monitor the speed of command takes about 48 clock cycles [6]. The total amount of clock cycles needed to process all 176 counts in one second is 48*176 = 8448 cycles per second. The Arduino's clock speed is

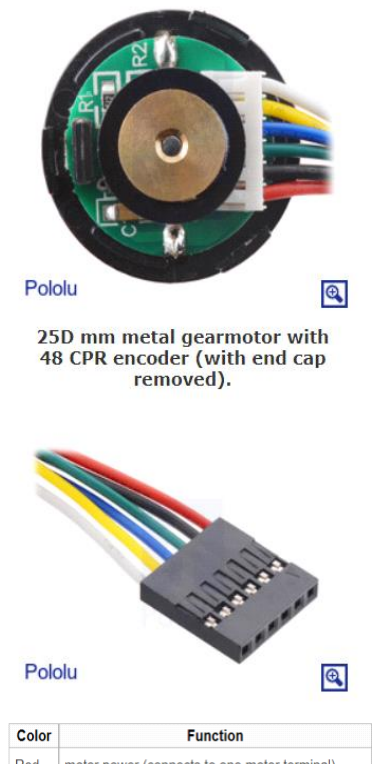
[picture p132: figure]

Figure 9: Hall Effect Encoder Connections Explanation [5]

Lastly, to ensure complete third party buildability, a full electrical schematic has been included to provide instruction on how all the pieces of the Mechanical Movement System intertwine with each other. Figure 10 shows those connections.

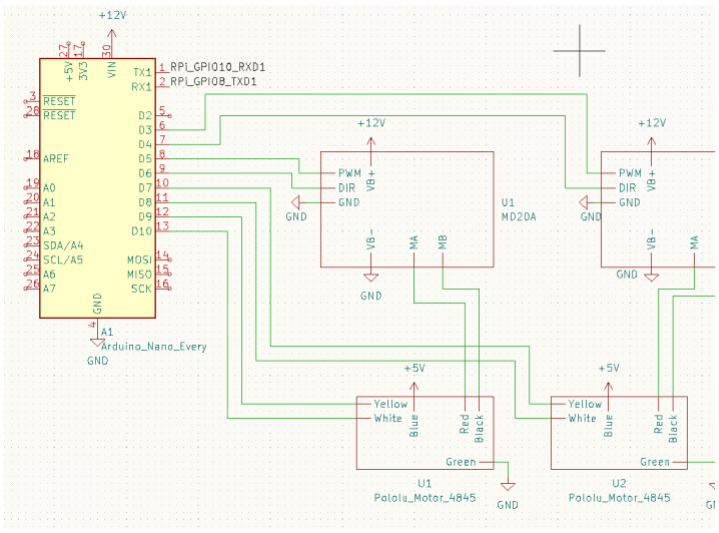
[picture p133: figure]

Figure 10: Electrical build for Mechanical Movement System

MD20A Motor Driver: $21.00 each (2 needed) Arduino Nano Every: $15.00

## Sources

[1] Motor Drivers are Important (https://sproboticworks.com/blog/choosing-the-right-motor-driver)
[2] MD20A from Cytron (https://makermotor.com/pn00218-cyt7-cytron-20a-6-30v-dc-motor-driver-md20a/?setCurrencyId=1)
[3] MD20A Datasheet (https://store-q63z26x00i.mybigcommerce.com/content/cytron/pn00218-cyt7/MD20A_Datasheet.pdf)
[4] Arduino Nano Every (https://store-usa.arduino.cc/products/arduino-nano-every-with-headers)
[5] Pololu Motor 4845 (https://www.pololu.com/product/4845)
[6] DigitalRead Time (https://forum.arduino.cc/t/how-many-clock-cycles-does-digitalread-write-take/467153/5)
