JoshuaEgwuatu/Fall-2023-Autonomous-Crawlspace-Inspection-Robot/Croomba V2/Documentation/Final BOM.md

| Name of Items |  Description | Used in which subsystem(s) | Part Number | Manufacturer | Quantity | Price | Total |
| --- | --- | --- | --- | --- | --- |  --- |  ---  |
| compass |3-Axis Digital Compass IC HMC5883L |  Enviromental | HMC5883L | adafruit | 1 |$9.95 |$9.95  |
| Arduino Nano |ATmega328 |  Enviromental | A000005 | Arduino | 1 |$24.90 |$24.90 |
|Metal DC Geared Motor |12V motor with a 90:1 metal gearbox|  Movement | GB37Y3530-12V-90EN | DFROBOT | 2 |$29.00 |$58.00 |
| | | | |Total Components| 4 |Total Cost |$92.85 |
