JoshuaEgwuatu/Fall-2023-Autonomous-Crawlspace-Inspection-Robot/Croomba V1/Documentation/Signoffs/Environmental Sensing/Models/Head_Assembly.SLDASM

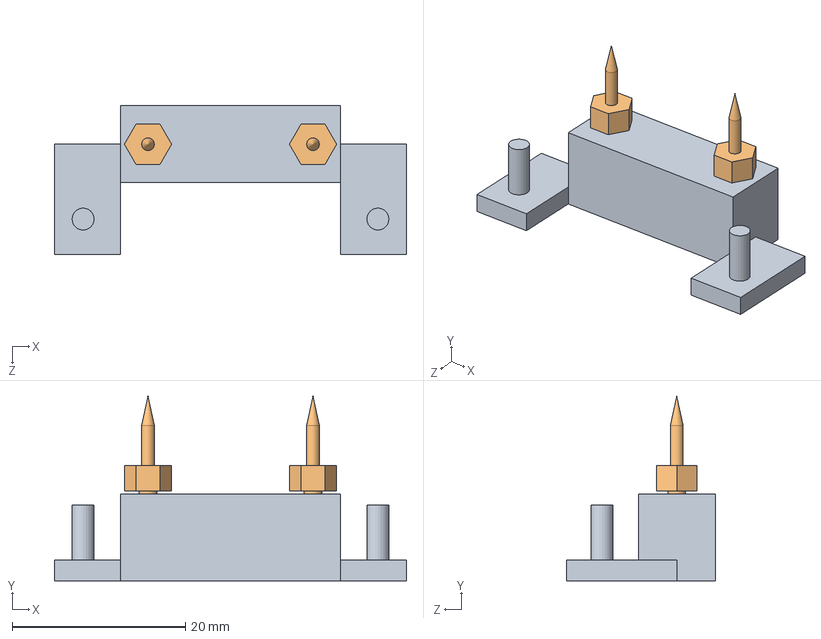
[picture p168: CAD file, 2023-12-01, an earlier design]
Croomba V1/Documentation/Signoffs/Environmental Sensing/Models/Head_Assembly.SLDASM
40.6 x 21.3 x 17.1 mm
Probe_Head
Probe x 2
