JoshuaEgwuatu/Fall-2023-Autonomous-Crawlspace-Inspection-Robot/Croomba V1/Documentation/Signoffs/Environmental Sensing/Models/Pulley.SLDPRT

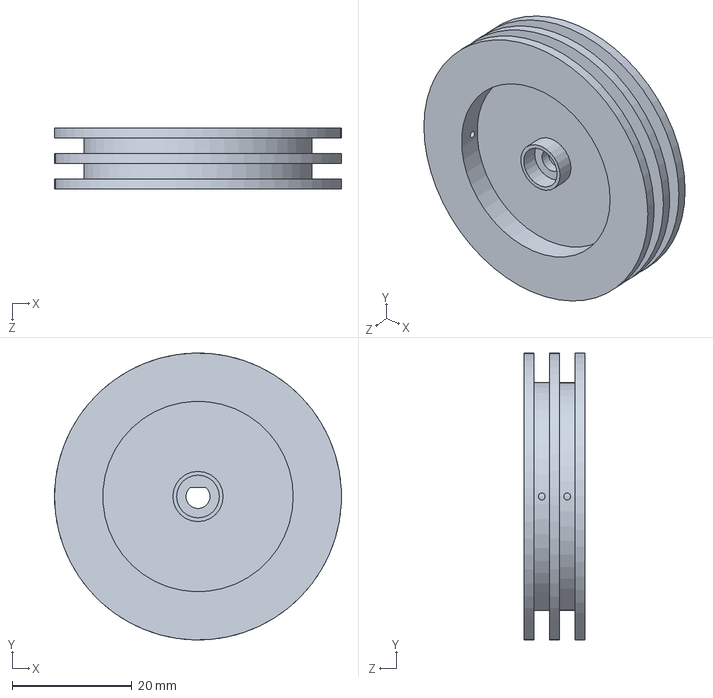
[picture p169: CAD file, 2023-12-01, an earlier design]
Croomba V1/Documentation/Signoffs/Environmental Sensing/Models/Pulley.SLDPRT
47.9 x 47.8 x 10.2 mm
