JoshuaEgwuatu/Fall-2023-Autonomous-Crawlspace-Inspection-Robot/Croomba V1/Documentation/Signoffs/Environmental Sensing/Models/Probe_Head.SLDPRT

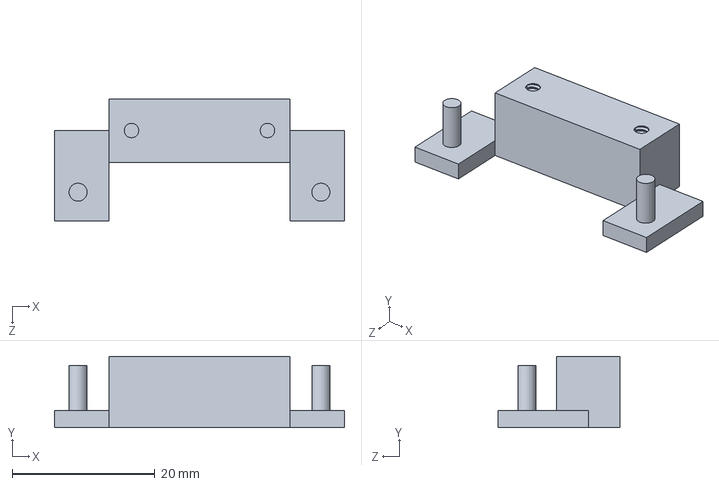
[picture p170: CAD file, 2023-12-01, an earlier design]
Croomba V1/Documentation/Signoffs/Environmental Sensing/Models/Probe_Head.SLDPRT
40.6 x 10.0 x 17.1 mm
