JoshuaEgwuatu/Fall-2023-Autonomous-Crawlspace-Inspection-Robot/Croomba V1/Documentation/Signoffs/Environmental Sensing/Models/Bracket.SLDPRT

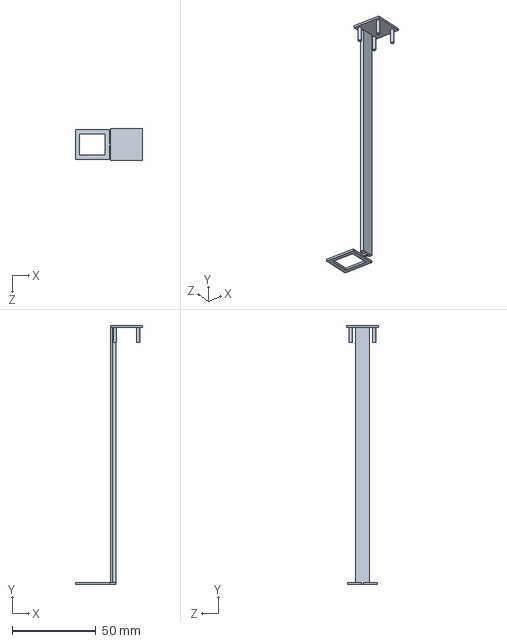
[picture p171: CAD file, 2023-12-01, an earlier design]
Croomba V1/Documentation/Signoffs/Environmental Sensing/Models/Bracket.SLDPRT
40.1 x 154.9 x 19.0 mm
