JoshuaEgwuatu/Fall-2023-Autonomous-Crawlspace-Inspection-Robot/Croomba V1/Documentation/Signoffs/Environmental Sensing/MC_PCB/MC_Probe/MC_Probe.kicad_pcb

## KiCad design Croomba V1/Documentation/Signoffs/Environmental Sensing/MC_PCB/MC_Probe/MC_Probe.kicad_pcb (2023-12-01, an earlier design)

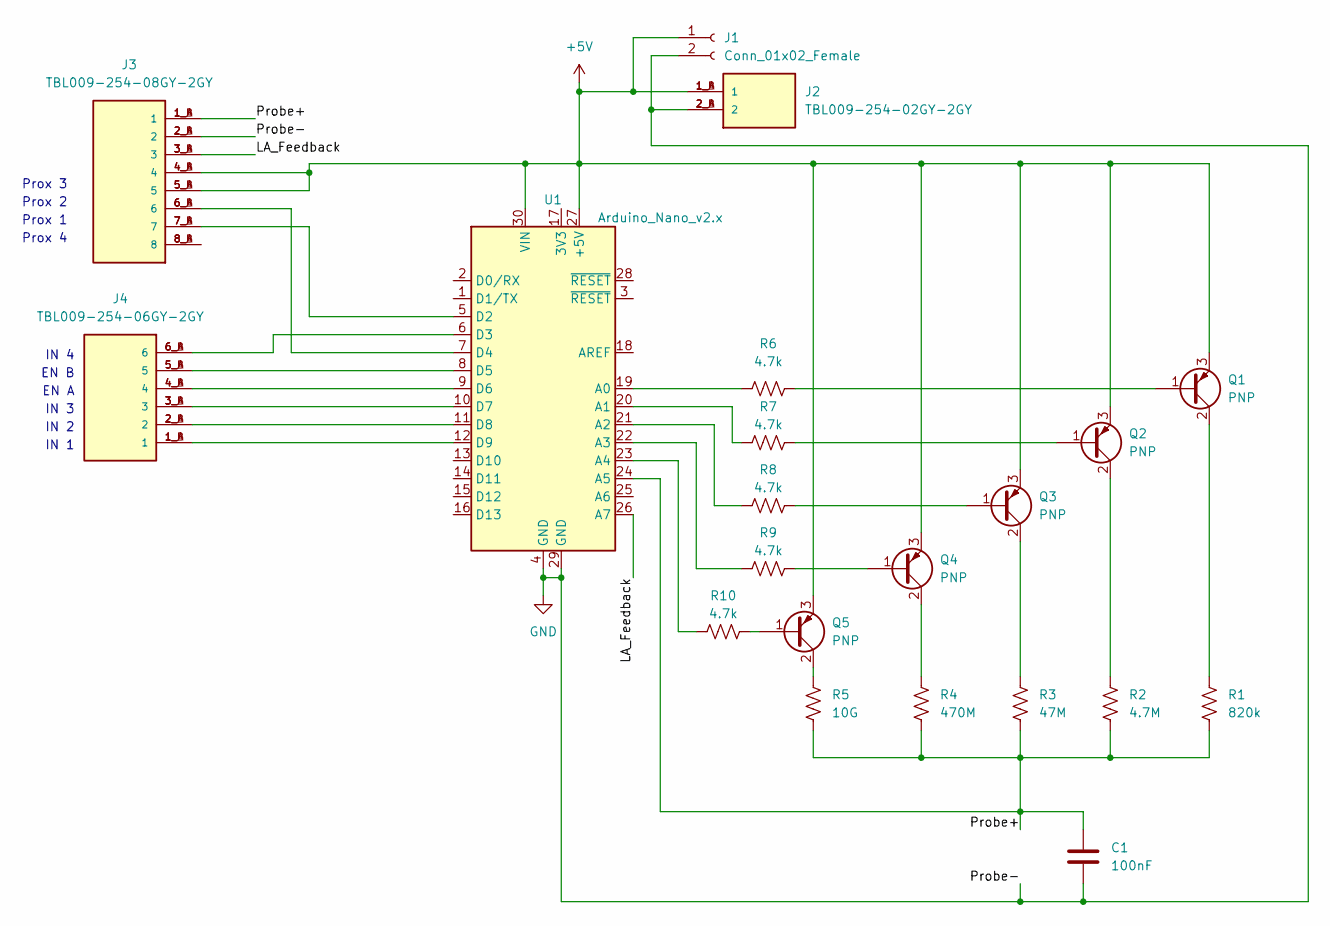
[picture p179: schematic MC_Probe.kicad_sch]

Parts:
C1: 100nF; C_1206_3216Metric
J1: Conn_01x02_Female; PinHeader_1x02_P2.54mm_Vertical
J2: TBL009-254-02GY-2GY; CUI_TBL009-254-02GY-2GY
J3: TBL009-254-08GY-2GY; CUI_TBL009-254-08GY-2GY
J4: TBL009-254-06GY-2GY; CUI_TBL009-254-06GY-2GY
Q1, Q2, Q3, Q4, Q5: PNP; TO-92
R1: 820k; R_1206_3216Metric
R2: 4.7M; R_1206_3216Metric
R3: 47M; R_1206_3216Metric
R4: 470M; R_1206_3216Metric
R5: 10G; R_1206_3216Metric
R6, R7, R8, R9, R10: 4.7k; R_1206_3216Metric
U1: Arduino_Nano_v2.x; Arduino_Nano_WithMountingHoles

Connections:
+5V: J1.1, J2.1_A (1), J2.1_B (1), J3.4_A (4), J3.4_B (4), J3.5_A (5), J3.5_B (5), Q1.3 (E), Q2.3 (E), Q3.3 (E), Q4.3 (E), Q5.3 (E), U1.27 (+5V), U1.30 (VIN)
/LA_Feedback: J3.3_A (3), J3.3_B (3), U1.26 (A7)
/Probe+: C1.1, J3.1_A (1), J3.1_B (1), R1.2, R2.2, R3.2, R4.2, R5.2, U1.24 (A5)
GND: C1.2, J1.2, J2.2_A (2), J2.2_B (2), J3.2_A (2), J3.2_B (2), U1.4 (GND), U1.29 (GND)
unnamed: J3.8_A (8), J3.8_B (8)
unnamed: J4.1_A (1), J4.1_B (1), U1.12 (D9)
unnamed: J4.2_A (2), J4.2_B (2), U1.11 (D8)
unnamed: J4.3_A (3), J4.3_B (3), U1.10 (D7)
unnamed: J4.4_A (4), J4.4_B (4), U1.9 (D6)
unnamed: J4.5_A (5), J4.5_B (5), U1.8 (D5)
unnamed: J4.6_A (6), J4.6_B (6), U1.6 (D3)
unnamed: Q1.1 (B), R6.2
unnamed: Q1.2 (C), R1.1
unnamed: Q2.1 (B), R7.2
unnamed: Q2.2 (C), R2.1
unnamed: Q3.1 (B), R8.2
unnamed: Q3.2 (C), R3.1
unnamed: Q4.2 (C), R4.1
unnamed: Q5.1 (B), R10.2
unnamed: Q5.2 (C), R5.1
unnamed: Q4.1 (B), R9.2
unnamed: J3.7_A (7), J3.7_B (7), U1.5 (D2)
unnamed: J3.6_A (6), J3.6_B (6), U1.7 (D4)
unnamed: R6.1, U1.19 (A0)
unnamed: R7.1, U1.20 (A1)
unnamed: R8.1, U1.21 (A2)
unnamed: R9.1, U1.22 (A3)
unnamed: R10.1, U1.23 (A4)

Notes on the sheet:
Prox 2
EN A
IN 1
EN B
IN 2
Prox 4
IN 4
Prox 3
IN 3
Prox 1

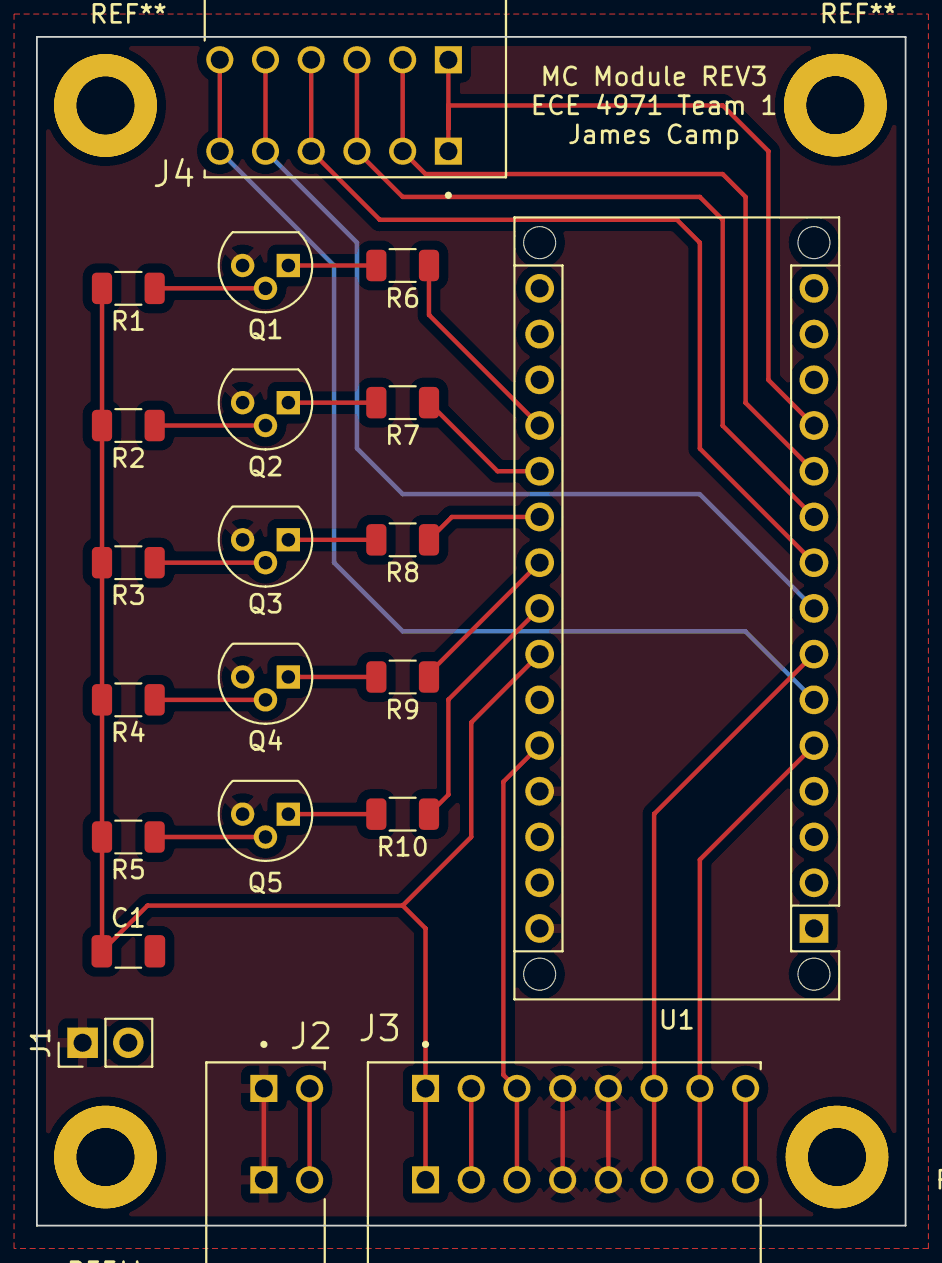
[picture p180: board MC_Probe.kicad_pcb from above]

Board: 2 copper layers, 48.3 x 66.0 mm, 21 parts (0 on the bottom side), 28 nets.
