JoshuaEgwuatu/Fall-2023-Autonomous-Crawlspace-Inspection-Robot/Croomba V1/Documentation/Signoffs/Environmental Sensing/Temperature_PCB/Temp_Module/Temp_Module.kicad_pcb

## KiCad design Croomba V1/Documentation/Signoffs/Environmental Sensing/Temperature_PCB/Temp_Module/Temp_Module.kicad_pcb (2023-12-01, an earlier design)

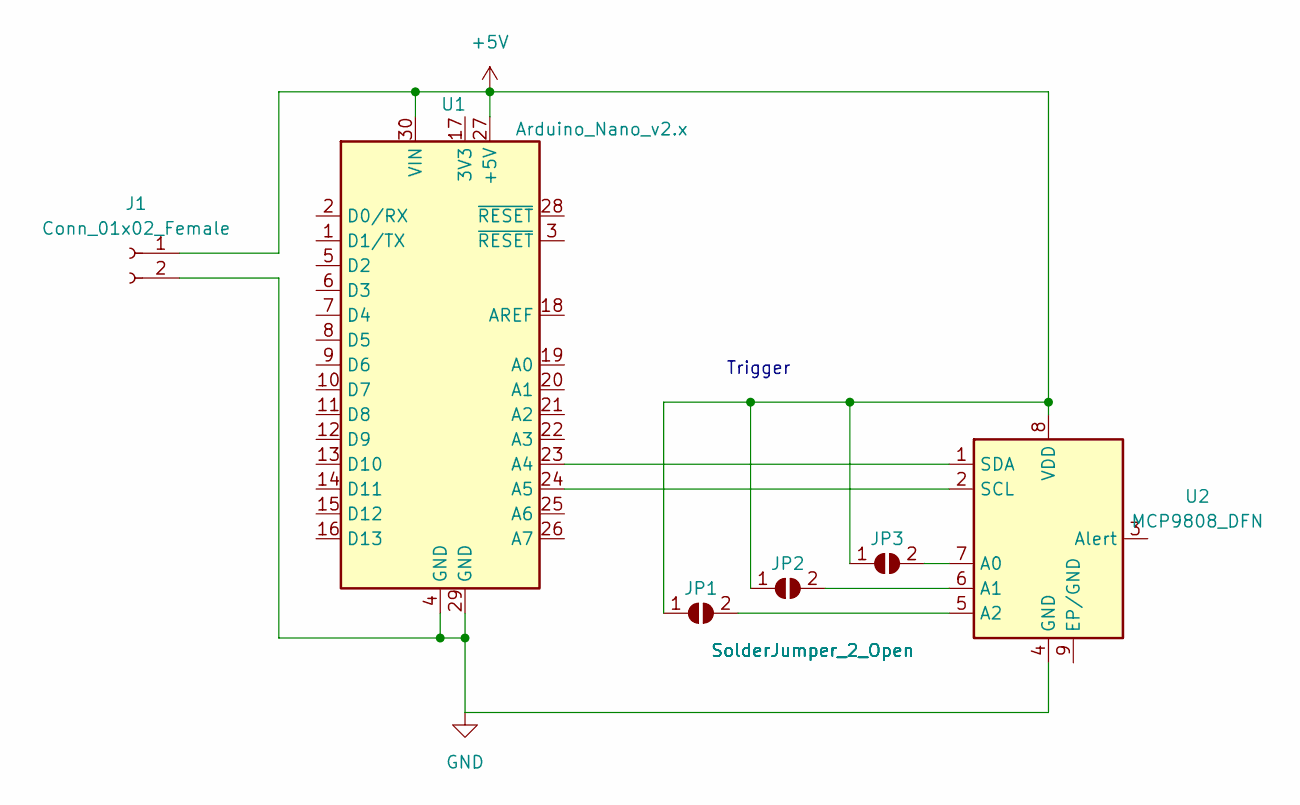
[picture p181: schematic Temp_Module.kicad_sch]

Parts:
J1: Conn_01x02_Female; PinHeader_1x02_P2.54mm_Vertical
JP1, JP2, JP3: SolderJumper_2_Open; SolderJumper-2_P1.3mm_Bridged2Bar_Pad1.0x1.5mm
U1: Arduino_Nano_v2.x; Arduino_Nano_WithMountingHoles
U2: MCP9808_DFN; DFN-8-1EP_3x2mm_P0.5mm_EP1.7x1.4mm

Connections:
+5V: J1.1, JP1.1 (A), JP2.1 (A), JP3.1 (A), U1.27 (+5V), U1.30 (VIN), U2.8 (VDD)
GND: J1.2, U1.4 (GND), U1.29 (GND), U2.4 (GND)
unnamed: JP1.2 (B), U2.5 (A2)
unnamed: JP2.2 (B), U2.6 (A1)
unnamed: JP3.2 (B), U2.7 (A0)
unnamed: U1.23 (A4), U2.1 (SDA)
unnamed: U1.24 (A5), U2.2 (SCL)

Notes on the sheet:
Trigger

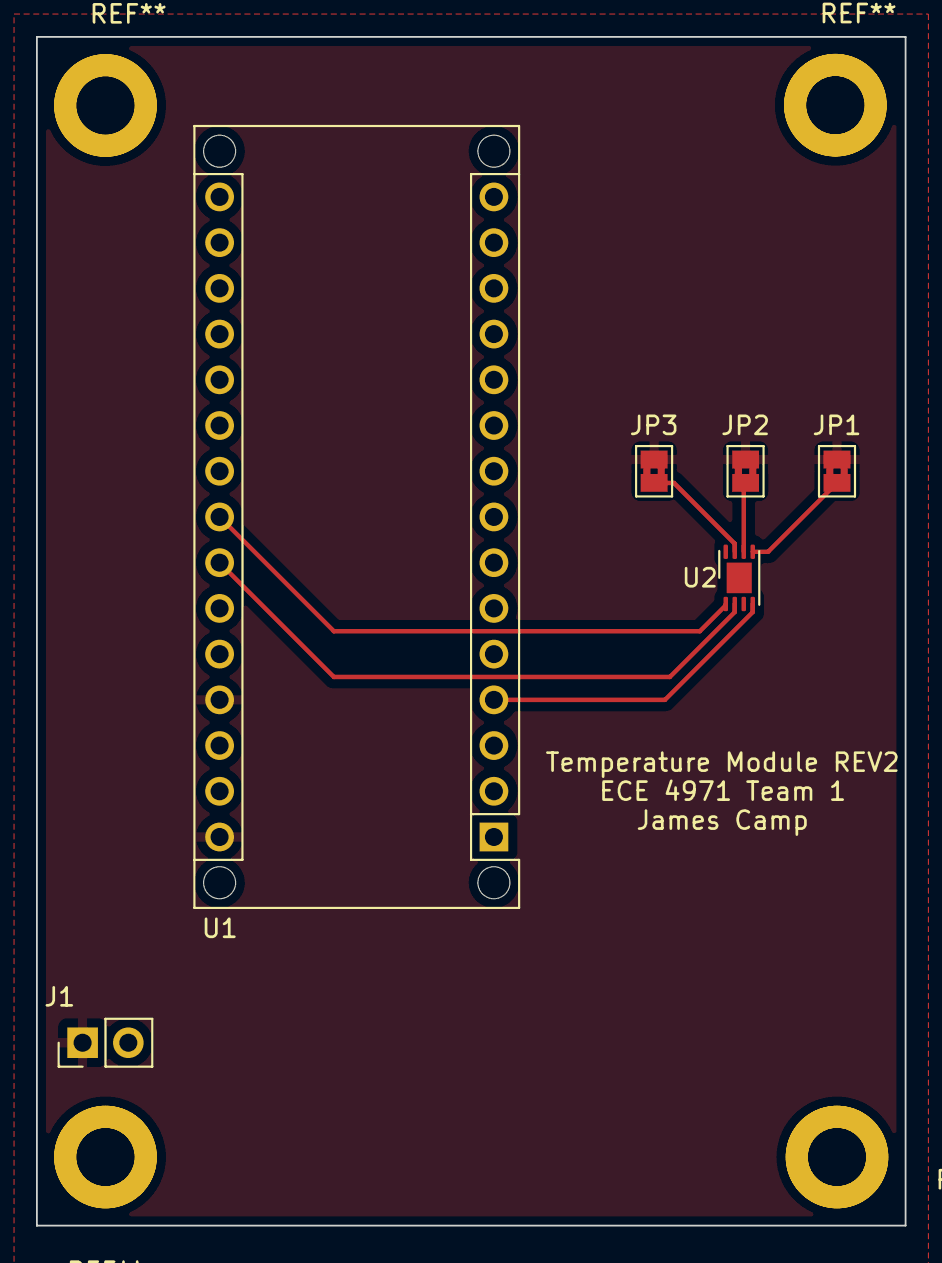
[picture p182: board Temp_Module.kicad_pcb from above]

Board: 2 copper layers, 48.3 x 66.0 mm, 6 parts (0 on the bottom side), 7 nets.
