JoshuaEgwuatu/Fall-2023-Autonomous-Crawlspace-Inspection-Robot/Croomba V1/Documentation/Signoffs/Environmental Sensing/Humidity_PCB/Humidity_Module/Humidity_Module.kicad_pcb

## KiCad design Croomba V1/Documentation/Signoffs/Environmental Sensing/Humidity_PCB/Humidity_Module/Humidity_Module.kicad_pcb (2023-12-01, an earlier design)

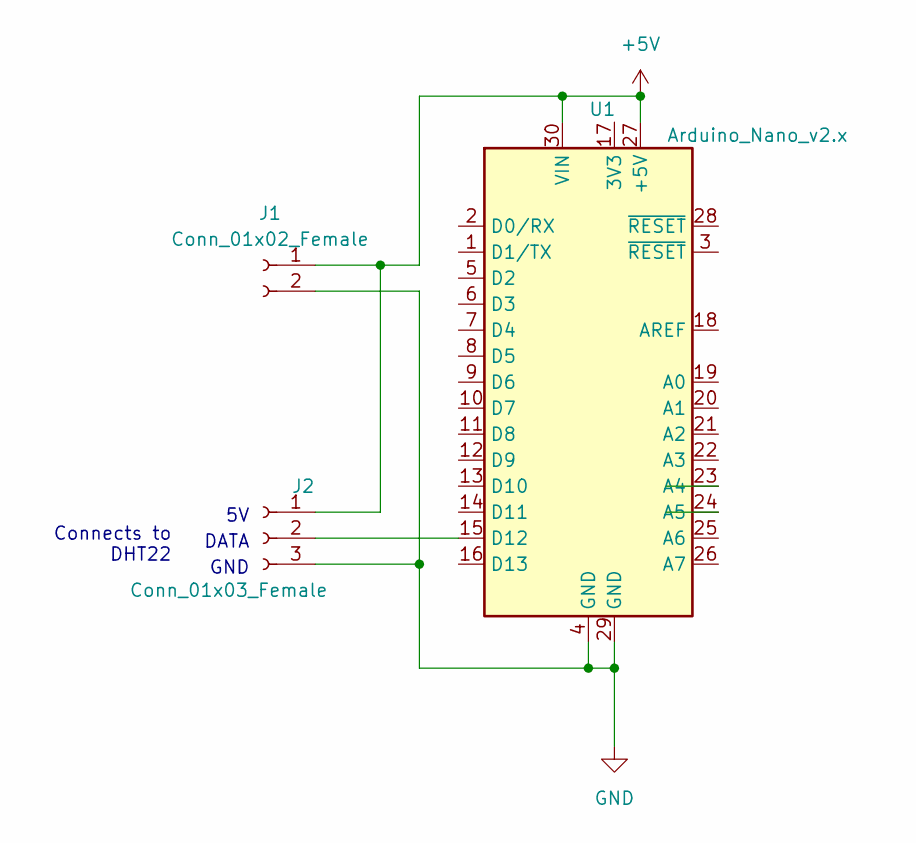
[picture p183: schematic Humidity_Module.kicad_sch]

Parts:
J1: Conn_01x02_Female; PinHeader_1x02_P2.54mm_Vertical
J2: Conn_01x03_Female; PinHeader_1x03_P2.54mm_Horizontal
U1: Arduino_Nano_v2.x; Arduino_Nano

Connections:
+5V: J1.1, J2.1, U1.27 (+5V), U1.30 (VIN)
GND: J1.2, J2.3, U1.4 (GND), U1.29 (GND)
unnamed: J2.2, U1.15 (D12)

Notes on the sheet:
Connects to DHT22
GND
DATA

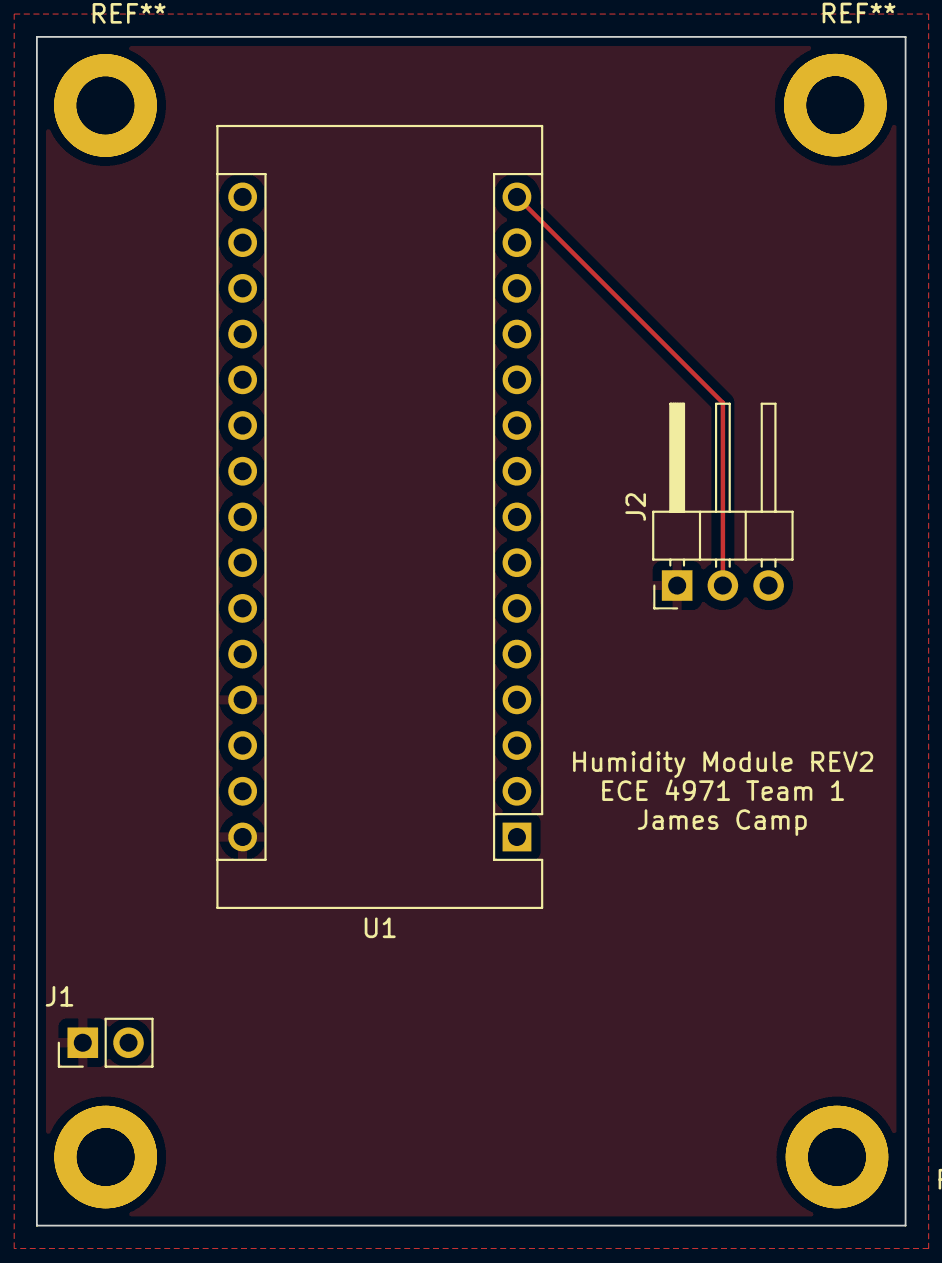
[picture p184: board Humidity_Module.kicad_pcb from above]

Board: 2 copper layers, 48.3 x 66.0 mm, 3 parts (0 on the bottom side), 3 nets.
