JoshuaEgwuatu/Fall-2023-Autonomous-Crawlspace-Inspection-Robot/(commit log)

2023-09-14 Create Livestream Camera Subsystem.md
2023-09-14 Create Radon Sensor Signoff.md
2023-09-14 Create Revamp Chassis and Motor Signoff.md
2023-09-18 Update Radon Sensor Signoff.md
2023-09-19 Update Radon Sensor Signoff.md
    updated the constraints
2023-09-21 Update Revamp Chassis and Motor Signoff.md
2023-09-28 Update Revamp Chassis and Motor Signoff.md
    function is updated
2023-10-02 Update GPS Subsystem.md
    constraint 3 is updated
    Analysis is updated
    Schematics are updated
2023-12-01 Create motor software.ino
2023-12-01 Create motor software.py
2023-12-01 Update motor software.ino
2023-12-02 Create Radon Sensor subsystem.md
2023-12-02 Update Radon Sensor subsystem.md
2023-12-02 Create Final BOM.md
2023-12-02 Create Full schematic.md
